AdakHaddad/mirror_NaSChipHack/pitch/README.md

# Pitch

Slide, naskah, dan video demo cadangan untuk Demo Day 23 Oktober 2026.

| File | Isi |
|---|---|
| [pitch_deck.md](pitch_deck.md) | Naskah 5 menit per slide |
| [question.md](question.md) | Persiapan tanya jawab 3 menit (jawaban bahasa Inggris) |
| [catatan-pembanding.md](catatan-pembanding.md) | Pembanding produk (BQ40Z50, DS28E38, ADI wBMS) |
