AdakHaddad/mirror_NaSChipHack/bisnis/README.md

# Business Model

Business model, analisis pasar, dan proyeksi dampak SeBatt.

| File | Isi |
|---|---|
| [business_model.md](business_model.md) | Model bisnis dan analisis pasar (TAM/SAM/SOM, pendapatan, GTM); sebagian angka belum bersumber — angka pitch final di `pitch-dan-angka.md` |
| [lean-canvas.md](lean-canvas.md) | Lean Canvas; bagian **[Isi]** dijawab di `pitch-dan-angka.md` |
| [pitch-dan-angka.md](pitch-dan-angka.md) | Naskah pitch, framework, asumsi angka bersumber, dan posisi startup |

Naskah demo day ada di [../pitch/pitch_deck.md](../pitch/pitch_deck.md);
pembanding produk di [../pitch/catatan-pembanding.md](../pitch/catatan-pembanding.md).

Aturan: setiap angka di dokumen mana pun harus berlabel **[Sumber]** (dengan
tautan) atau **[Asumsi]** (dengan dasar). Angka tanpa label jangan dipakai di
pitch.
