AdakHaddad/mirror_NaSChipHack/docs/catatan-teknis/council-18-okt.md

# Catatan Teknis 18 Oktober 2026

Ringkasan diskusi Guntur tentang arah teknis dan demo menjelang onsite. Dibaca semua anggota sebelum rapat.

> **Revisi 19 Okt 2026:** keputusan ADC berubah — **ADS1115 (I2C)** menggantikan MCP3202 (SPI) karena modul SPI tidak tersedia. Board latihan tetap **Cmod S7**; KV260 hari-H. Angka dan keputusan lain di catatan ini tetap berlaku.

## Kenapa Arah Perlu Disesuaikan

Proposal yang lolos menjanjikan dua hal yang akan dicek juri:

1. Setiap sampel tegangan dari ADC diberi **nomor urut** dan **ditandatangani HMAC** di dalam chip, lalu disimpan sebagai **riwayat**. Stasiun menolak riwayat yang diubah atau dihapus.
2. Semua itu dikerjakan **rangkaian RTL tanpa prosesor lunak**.

Poin 1 adalah satu-satunya pembeda SeBatt dari chip komersial. TI BQ40Z50 sudah mengukur tegangan, menyimpan *lifetime log*, dan punya SHA-1 untuk mengautentikasi **paket** kepada host. Yang tidak dimilikinya adalah tanda tangan atas riwayat itu sendiri: log tersimpan polos di data flash, tanpa nomor urut, dan dapat ditulis ulang lewat akses data flash (bqStudio). Pembanding terkuatnya pun begitu: MAX17205 memakai SHA-256, tetapi tetap hanya anti-kloning paket, bukan integritas riwayat.

Kondisi repo saat ini:

- Core SHA-256 dan HMAC sudah lolos 9/9 vektor uji. Ini fondasi yang tetap dipakai.
- Desain FPGA memakai MicroBlaze dan firmware C di Nexys A7/Basys 3. Saat onsite kita wajib memakai **AMD Kria KV260** dari panitia, dan proposal menulis tanpa prosesor lunak.
- ADC, nomor urut, buffer riwayat, dan lock di chip belum ada. Tegangan masih angka tetap 3700 mV.

## Keputusan yang Diusulkan

- Jalur MicroBlaze **dibekukan** dan disimpan sebagai cadangan, tidak dihapus.
- Tenaga RTL dialihkan ke rangkaian ini, semuanya di logika FPGA:

```
ADC (ADS1115) → i2c_master + ads1115_ctrl → auth_ctrl (nomor urut, buffer riwayat, lock) → hmac_sha256 → uart_if → laptop stasiun
```

- Gambaran alurnya ada di [gambar alur teknis](../gambar/alur-teknis.png). Format pesan UART, perintah riwayat, dan kode status disepakati di rapat sebagai kontrak antara Muqtada (RTL) dan Budi (Python).

## Catatan KV260

- **Clock** logika FPGA berasal dari prosesor ARM di board, jadi blok Zynq UltraScale+ MPSoC tetap dipasang di block design sebagai sumber clock.
- **Cara menjalankan.** Boot image Ubuntu KV260 dari SD card, lalu muat bitstream dengan `xmutil` atau `fpgautil`. Bagian ini cocok dipegang Muqtada karena terbiasa dengan Linux.
- **UART** bawaan board terhubung ke prosesor, bukan ke logika FPGA. UART dari rangkaian kita keluar lewat **PMOD** dan adaptor USB-UART (misalnya CP2102).
- **Hanya ada satu PMOD** (8 pin). Pin itu cukup untuk ADS1115 I2C (2 pin), UART (2 pin), dan LED (1 pin).
- Board baru kita pegang 21 Oktober, jadi seluruh rangkaian **diuji dulu di Cmod S7**.
- Cek apakah instalasi Vivado sudah mendukung device **xck26**.

## Rancangan Demo

Cerita: baterai dipakai sekitar seminggu, sekali dikuras sampai habis, lalu catatan kejadian itu dihapus.

1. **Pemakaian normal.** Hasilnya diterima.
2. **Juri memutar kenop** sampai baterai terkuras, lalu catatannya dihapus. Layar menampilkan "Catatan jam 14–17 hilang, DITOLAK".
3. **Angka diubah** dari 2,0 V menjadi 3,6 V. Hasilnya "DITOLAK".

Ketentuan pendukung:

- Tulisan di layar memakai bahasa awam, tanpa kode status. Hurufnya besar.
- Satu slide pembanding: "BMS biasa: DITERIMA", "SeBatt: DITOLAK".
- Peran BMS curang dijalankan di **laptop kedua**, di antara board dan laptop stasiun.
- Board diberi label "CHIP SeBatt", dan LED besar di breadboard menyala hijau atau merah.
- Buffer berisi 64 sampel. Satu titik mewakili 3 jam, jadi totalnya sekitar 8 hari.
- Apabila board tidak merespons dalam 10 detik, video cadangan diputar.
- Replay dan lock tidak ditampilkan di demo. Keduanya disiapkan untuk tanya jawab.

## Pembagian Tugas

| Orang | Tugas |
|---|---|
| Muqtada | auth_ctrl (nomor urut, buffer, lock). Boot KV260 dan memuat bitstream |
| Guntur | i2c_master + ads1115_ctrl, uart_if, membeli dan merangkai ADS1115, uji di Cmod S7, constraint PMOD KV260, pitch deck |
| Budi | Dashboard stasiun, program BMS curang, testbench cocotb, dataset cadangan dari data baterai, angka bisnis bersumber |

## Jadwal

| Waktu | Target |
|---|---|
| Senin 19 Okt | Sepakat soal MicroBlaze dan protokol. Beli ADS1115, adaptor USB-UART, potensiometer |
| Selasa 20 Okt | Rangkaian lengkap jalan di Cmod S7. Video cadangan direkam |
| Rabu 21 Okt | Boot dan port ke KV260 |
| Kamis 22 Okt, 22.00 | Kirim slide, repositori, dan README 2 halaman |
| Jumat 23 Okt, 08.00 | Batas pengumpulan panitia |

README 2 halaman wajib memuat diagram blok, cara menjalankan, hasil uji, dan poin penggunaan AI.

## Jawaban untuk Pertanyaan Juri

| Pertanyaan | Jawaban |
|---|---|
| Kalau daya dicabut? | Nomor urut kembali ke nol, dan stasiun mendeteksinya sebagai rollback. Produk akhir butuh penghitung permanen (NVM) |
| Apakah kunci bisa dibaca? | Di produk tidak. key_vault dibuat sekali tulis tanpa port baca, dan setiap chip punya kunci berbeda |
| Apakah data ADC bisa dipalsukan? | Bisa, sebelum masuk chip. Pada chip akhir, ADC berada di dalam chip yang sama |
| Kalau basis data bocor? | Kunci ikut bocor. Ini batasan skema kunci simetris |
| Apa bedanya dengan BQ40Z50? | BQ40Z50 menyimpan lifetime log dan punya SHA-1, tetapi keduanya untuk keaslian paket: host mengautentikasi identitas, bukan isi riwayat. Log-nya tidak ditandatangani, tanpa nomor urut, dan dapat ditulis ulang lewat akses data flash. SeBatt menandatangani setiap sampel di titik ukur, sehingga riwayat yang diubah, dihapus, atau diputar balik tertolak |

## Pembanding Produk dan Riset

Ancaman yang dijawab SeBatt berbeda dari pembanding yang ada. Produk dan riset di bawah ini melindungi pemilik merek dari pemalsu atau penyerang jaringan, sedangkan SeBatt melindungi stasiun dan pembeli dari pemilik baterai yang memanipulasi riwayat baterainya sendiri.

| | TI BQ40Z50 | ADI MAX17205 | SeBatt |
|---|---|---|---|
| Riwayat | Lifetime log + black box recorder, diperbarui tiap 2 jam | History log | Tiap sampel tegangan bernomor urut |
| Tanda tangan riwayat | Tidak ada | Tidak ada | HMAC-SHA-256 per sampel, di dalam IP |
| Anti-rollback | Tidak ada | Tidak ada | Nomor urut + anchor last_seq di stasiun |
| Autentikasi yang ada | SHA-1, host mengautentikasi paket (anti-kloning) | SHA-256, 160-bit, anti-kloning | Identitas dari PUF, riwayat dari tanda tangan |
| Kunci | Secure memory di gauge | 160-bit secret key | Dari PUF, tidak disimpan permanen (tahap 2) |

Rujukan pembanding:

- TI, *BQ40Z50 datasheet* — lifetime log, black box recorder, SHA-1: <https://www.ti.com/lit/ds/symlink/bq40z50.pdf>
- ADI, *MAX17205* — SHA-256 untuk anti-kloning paket: <https://www.analog.com/en/products/max17205.html>
- Basic dkk. (Graz), "Secure Data Acquisition for Battery Management Systems", DSD 2023 — struktur log BMS dan pengamanan transfer ke cloud: <https://doi.org/10.1109/DSD60849.2023.00082>
- Marchiori & Conti, "Your Battery Is a Blast!", CCS 2023 — autentikasi baterai dari ciri sel: <https://doi.org/10.1145/3576915.3623179>
- Blümke dkk., "Security Concerns in Transitioning BMS from First to Second Life", ARES 2024 — verifikasi integritas data sebagai kebutuhan saat transisi: <https://doi.org/10.1145/3664476.3671010>

## Kerapian Repositori

- File hasil generate Vivado (.dcp, .xci, cache) dikeluarkan dari repo. Proyek dibangun ulang dari skrip TCL.
- Tambahkan .gitattributes agar perbedaan line ending Windows dan Linux tidak membuat diff palsu.
- Atur email git sesuai akun GitHub masing-masing:

```
git config --global user.email "email@contoh.com"
```
