AdakHaddad/mirror_NaSChipHack/pitch/pitch_deck.pdf

[Team ID] – [Team name]

# How to use this template

### Delete this slide before presenting

- The theme (design) of this template must be used for your pitch slides.
- All slides must be written in English. Presenting in English is strongly encouraged.
- The content, titles, order, and number of slides here are examples only. Change them freely, as long as they fit your presentation time.
- Grey text in [square brackets] is guidance only. Replace it with your own content.
- Your team decides how to split the slot between presentation and demo.
- Save as PDF or PPTX and submit before Day 3 at 08:00 WIB.

## T01 – NaS

# SeBatt

## Secure Battery Identity & Tamper-Evident History

## Internet of Things · Universitas Gadjah Mada

### Guntur Sulistyo · Muhammad Budi Setiawan · Muhammad Muqtada Alhaddad

Hackathon Deeptech 2026 · Demo Day, 23 October 2026

Condition | Problem | Solution
Battery are shared, so the station 139,45 M | must trust a battery.

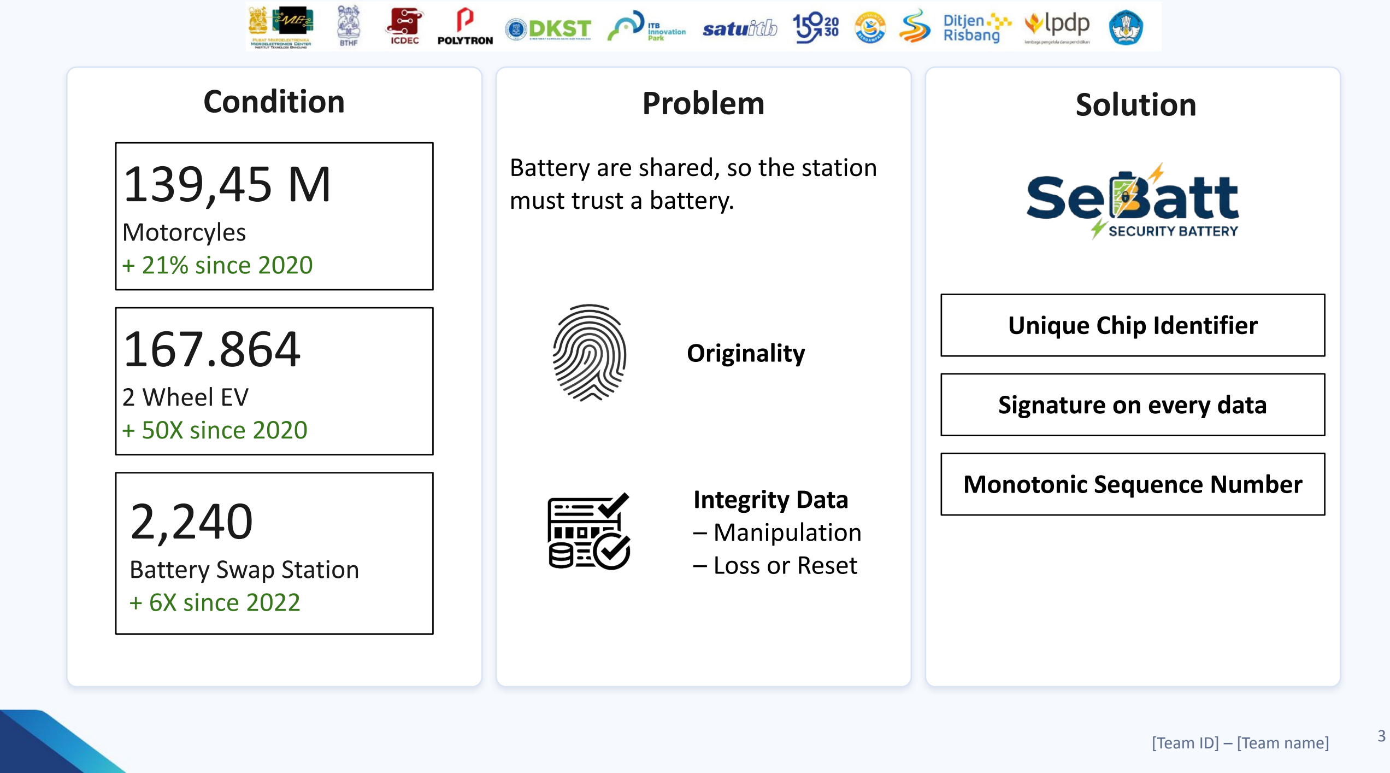
[picture p6: page 3]

[Team ID] – [Team name] 3

## Motorcyles + 21% since 2020

167.864

## 2 Wheel EV + 50X since 2020

2,240

## Battery Swap Station + 6X since 2022

## Originality

## Integrity Data – Manipulation – Loss or Reset

## Unique Chip Identifier

## Signature on every data

## Monotonic Sequence Number

Key Activities | Key Resource | Key Partnership
| IP Design & HKI

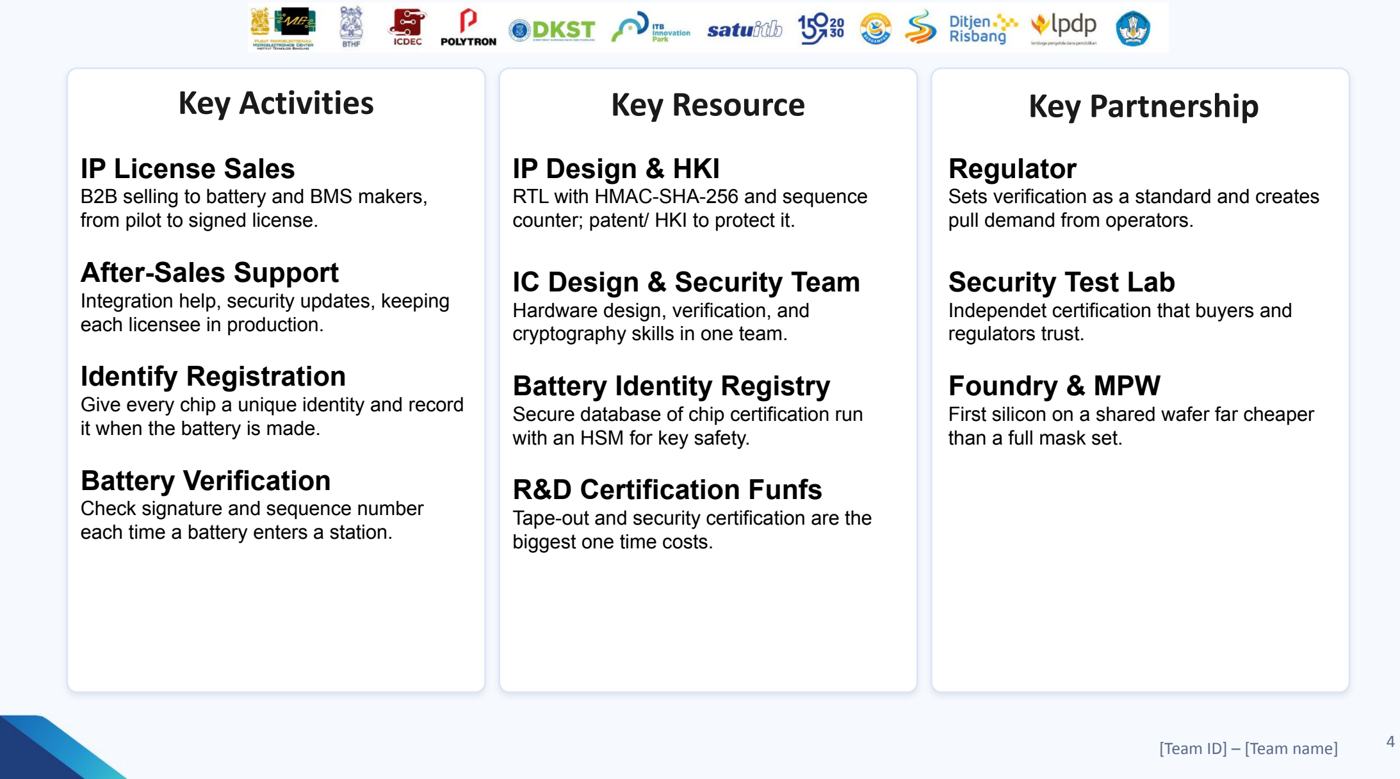
[picture p7: page 4]

[Team ID] – [Team name] 4

## IP License Sales

B2B selling to battery and BMS makers, from pilot to signed license.

## After-Sales Support

Integration help, security updates, keeping each licensee in production.

## Identify Registration

Give every chip a unique identity and record it when the battery is made.

## Battery Verification

Check signature and sequence number each time a battery enters a station.

RTL with HMAC-SHA-256 and sequence counter; patent/ HKI to protect it.

## IC Design & Security Team

Hardware design, verification, and cryptography skills in one team.

## Battery Identity Registry

Secure database of chip certification run with an HSM for key safety.

## R&D Certification Funfs

Tape-out and security certification are the biggest one time costs.

## Regulator

Sets verification as a standard and creates pull demand from operators.

## Security Test Lab

Independet certification that buyers and regulators trust.

## Foundry & MPW

First silicon on a shared wafer far cheaper than a full mask set.

Customer Segment | Channels | Customer Relationship
| Awareness

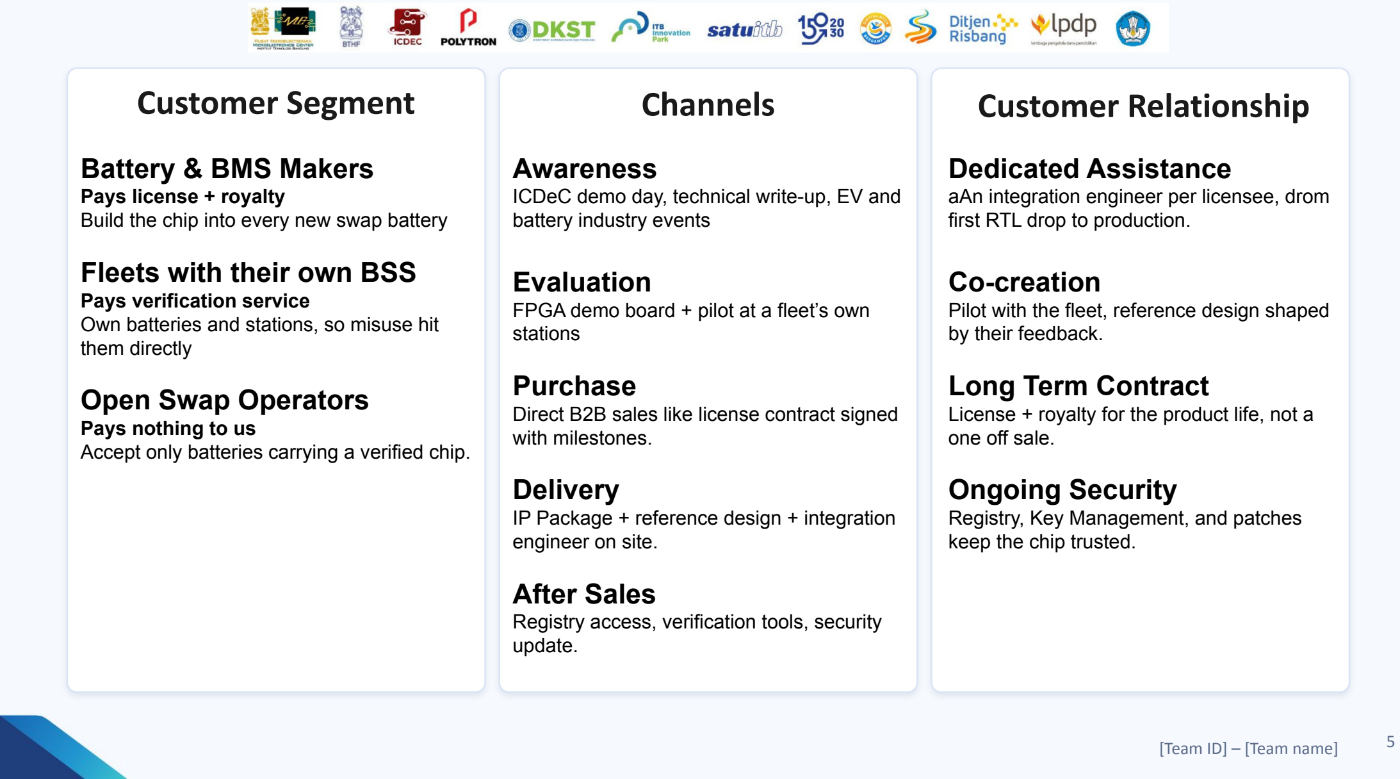
[picture p8: page 5]

[Team ID] – [Team name] 5

## Battery & BMS Makers

Pays license + royalty
Build the chip into every new swap battery

## Fleets with their own BSS

Pays verification service
Own batteries and stations, so misuse hit them directly

## Open Swap Operators

Pays nothing to us
Accept only batteries carrying a verified chip.

ICDeC demo day, technical write-up, EV and battery industry events

## Evaluation

FPGA demo board + pilot at a fleet’s own stations

## Purchase

Direct B2B sales like license contract signed with milestones.

## Delivery

IP Package + reference design + integration engineer on site.

## After Sales

Registry access, verification tools, security update.

## Dedicated Assistance

aAn integration engineer per licensee, drom first RTL drop to production.

## Co-creation

Pilot with the fleet, reference design shaped by their feedback.

## Long Term Contract

License + royalty for the product life, not a one off sale.

## Ongoing Security

Registry, Key Management, and patches keep the chip trusted.

# Cost Structure

## One Time

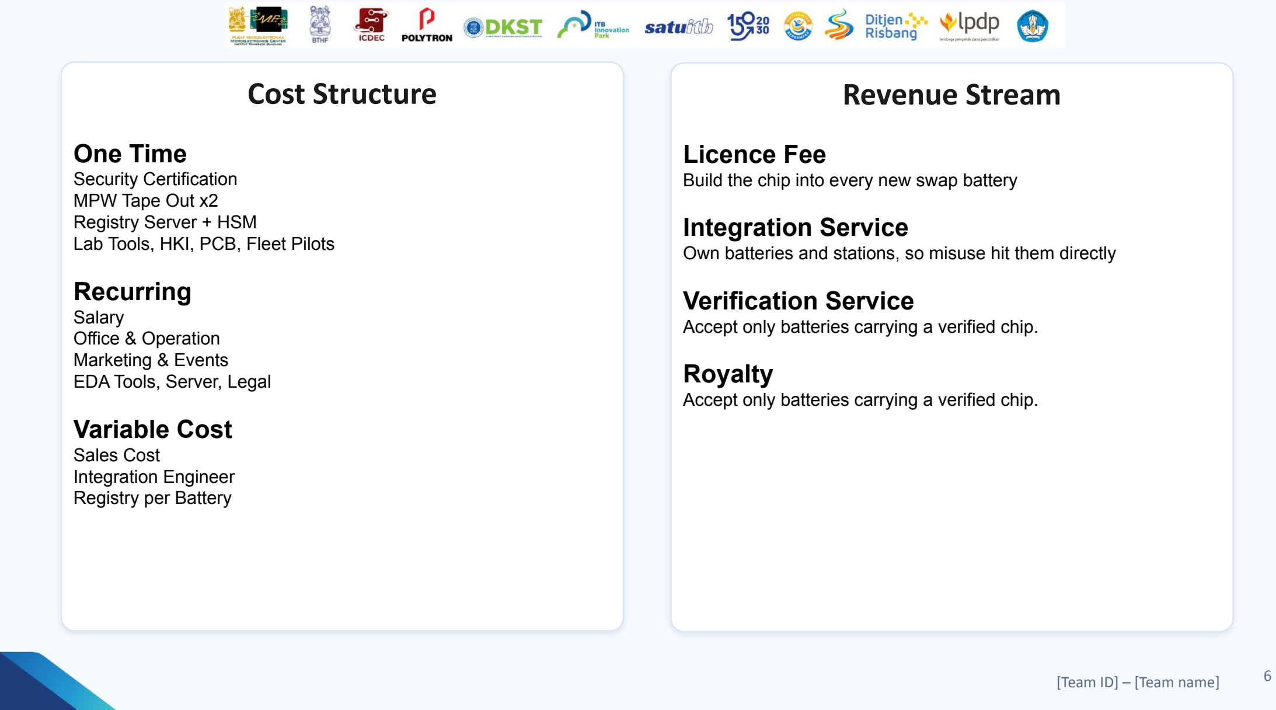
[picture p9: page 6]

[Team ID] – [Team name] 6

Security Certification
MPW Tape Out x2
Registry Server + HSM
Lab Tools, HKI, PCB, Fleet Pilots

## Recurring

Salary
Office & Operation
Marketing & Events
EDA Tools, Server, Legal

## Variable Cost

Sales Cost
Integration Engineer
Registry per Battery

# Revenue Stream

## Licence Fee

Build the chip into every new swap battery

## Integration Service

Own batteries and stations, so misuse hit them directly

## Verification Service

Accept only batteries carrying a verified chip.

## Royalty

Accept only batteries carrying a verified chip.

# Trend of EV Motorcycle

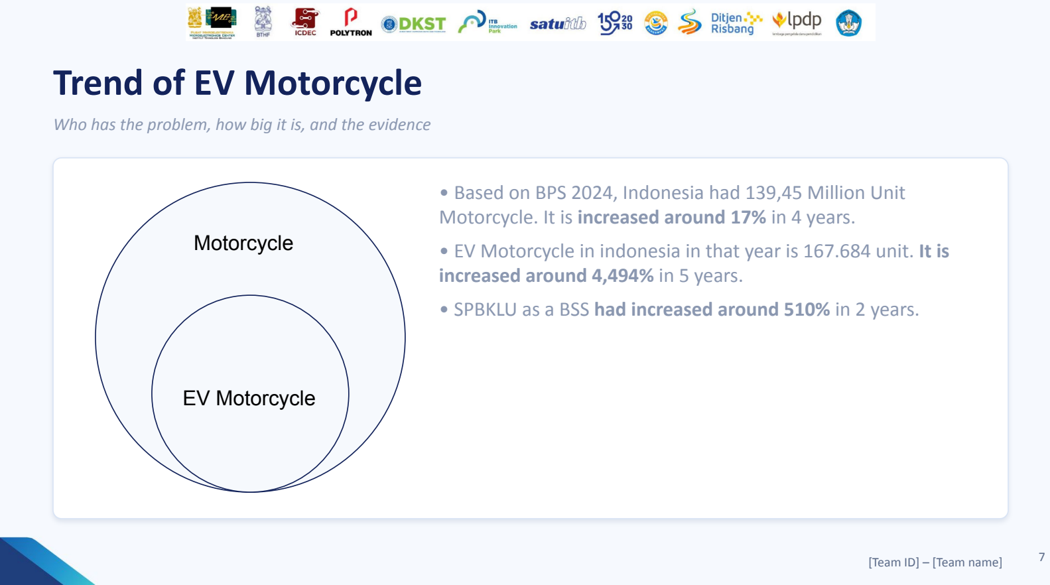
[picture p10: page 7]

### Who has the problem, how big it is, and the evidence

## - Based on BPS 2024, Indonesia had 139,45 Million Unit

Motorcycle. It is increased around 17% in 4 years.

## - EV Motorcycle in indonesia in that year is 167.684 unit. It is

increased around 4,494% in 5 years.

- SPBKLU as a BSS had increased around 510% in 2 years.

## Motorcycle

## EV Motorcycle

# Battery Swap EV Motorcycle

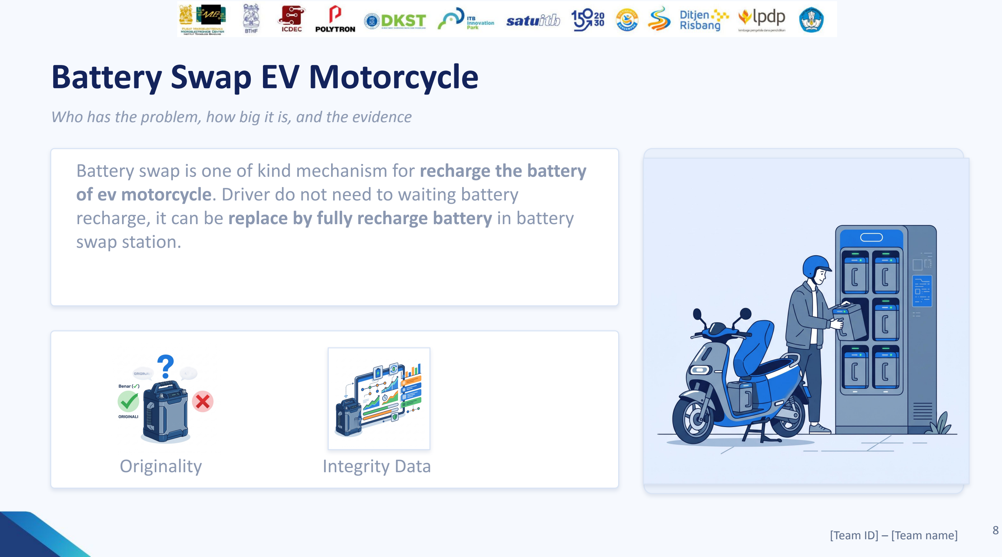
[picture p11: page 8]

### Who has the problem, how big it is, and the evidence

## Battery swap is one of kind mechanism for recharge the battery of ev motorcycle. Driver do not need to waiting battery recharge, it can be replace by fully recharge battery in battery

swap station. | [Key figure]

### [Short explanation of the figure and its data source]

Originality | Integrity Data

# How SeBatt can Solve the Problem

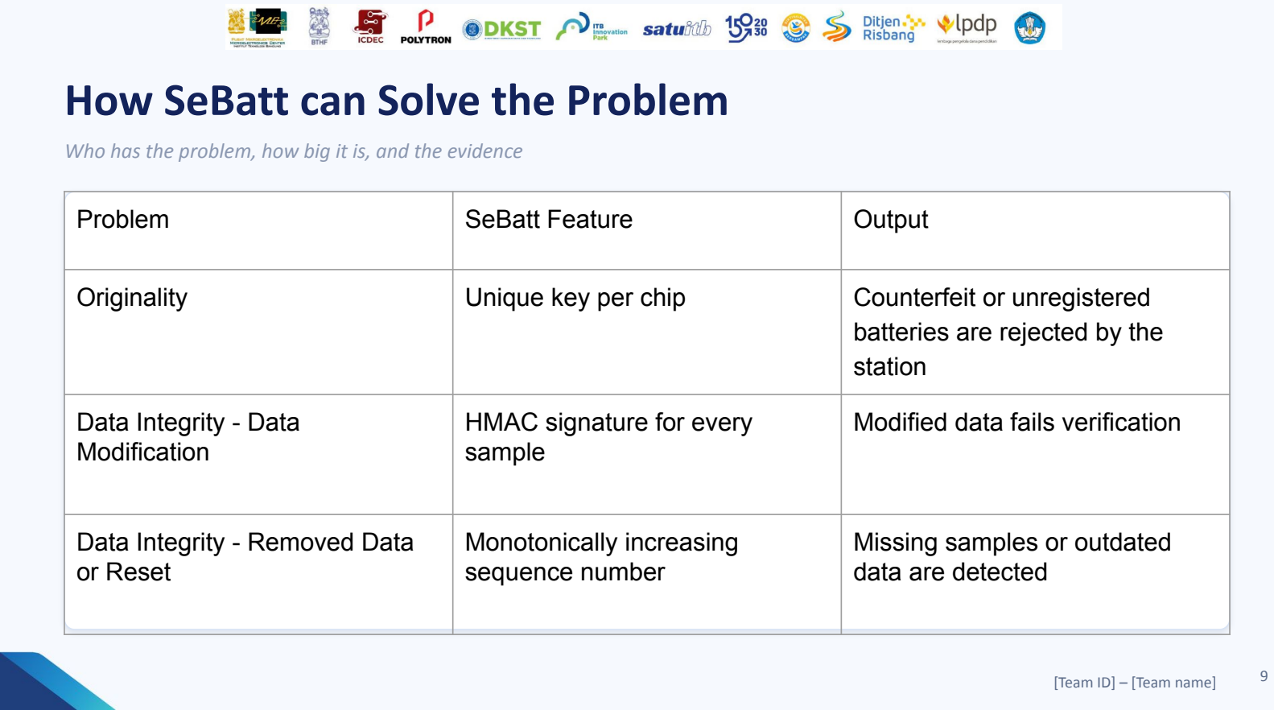
[picture p12: page 9]

### Who has the problem, how big it is, and the evidence

Problem | SeBatt Feature | Output
Originality | Unique key per chip | Counterfeit or unregistered batteries are rejected by the station
Data Integrity - Data Modification | HMAC signature for every sample | Modified data fails verification
Data Integrity - Removed Data or Reset | Monotonically increasing sequence number | Missing samples or outdated data are detected

# Positioning SeBatt

Kemampuan | DS28E38 | BQ40Z50 | ADI wBMS | SeBatt

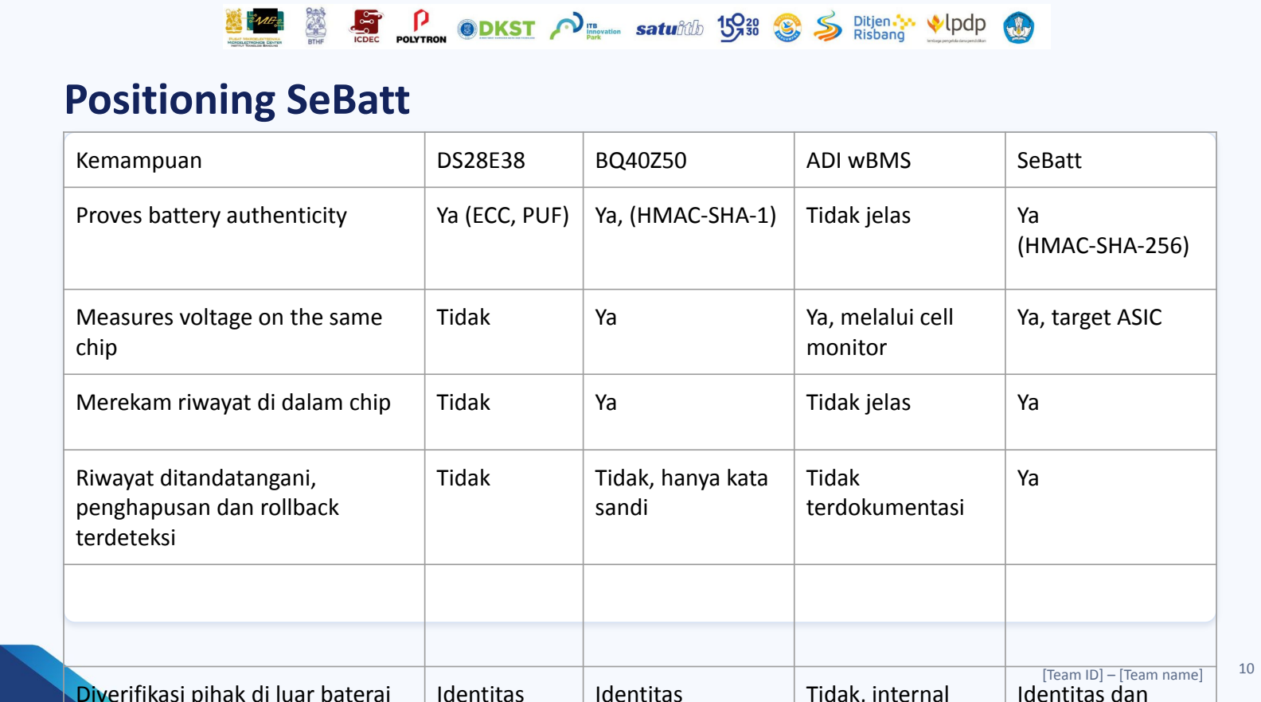
[picture p13: page 10]

Proves battery authenticity | Ya (ECC, PUF) | Ya, (HMAC-SHA-1) | Tidak jelas | Ya (HMAC-SHA-256)
Measures voltage on the same chip | Tidak | Ya | Ya, melalui cell monitor | Ya, target ASIC
Merekam riwayat di dalam chip | Tidak | Ya | Tidak jelas | Ya
Riwayat ditandatangani, penghapusan dan rollback terdeteksi | Tidak | Tidak, hanya kata sandi | Tidak terdokumentasi | Ya
Diverifikasi pihak di luar baterai | Identitas | Identitas | Tidak, internal

## Identitas dan

# Competitor Analysis

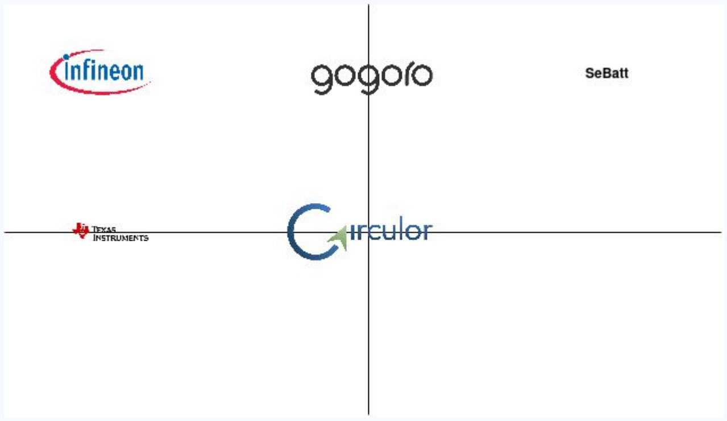
[picture p14: figure]

# Solution and system architecture

### How it works from input to output

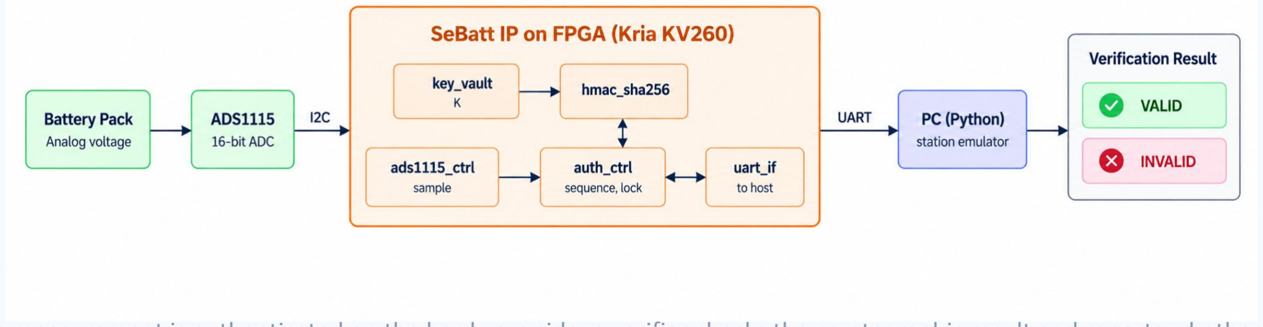
[picture p15: figure]

The measurement is authenticated on the hardware side; a verifier checks the cryptographic result and reports whether the tested record matches. The current PoC validates fixed-input RTL and offline verification; live ADC-to-history integration is still planned.

# Role of the chip

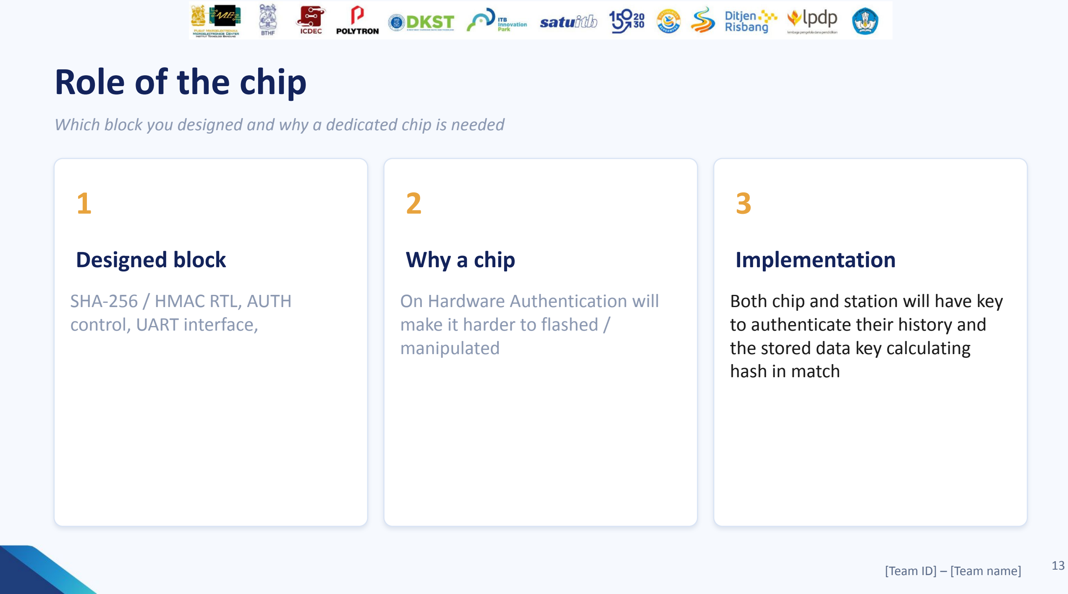
[picture p16: page 13]

### Which block you designed and why a dedicated chip is needed

1

## Designed block

## SHA-256 / HMAC RTL, AUTH

control, UART interface,

2

## Why a chip

## On Hardware Authentication will make it harder to flashed / manipulated

3

## Implementation

## Both chip and station will have key to authenticate their history and the stored data key calculating hash in match

# PoC demo and evaluation results

### What works and how well it performs

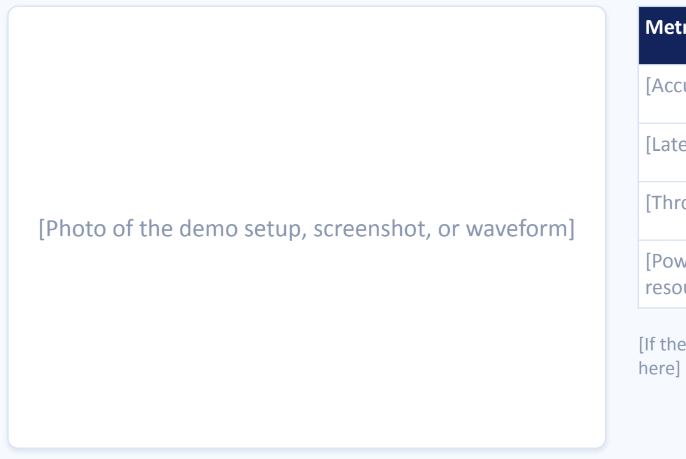
[picture p17: figure]
here]

## [Photo of the demo setup, screenshot, or waveform]

Metric | Result | Target / baseline
[Accuracy] | [...] | [...]
[Latency] | [...] | [...]
[Throughput] | [...] | [...]
[Power / FPGA resources] | [...] | [...]

[If the input comes from data rather than a live sensor, state it

# Design Timing Summary

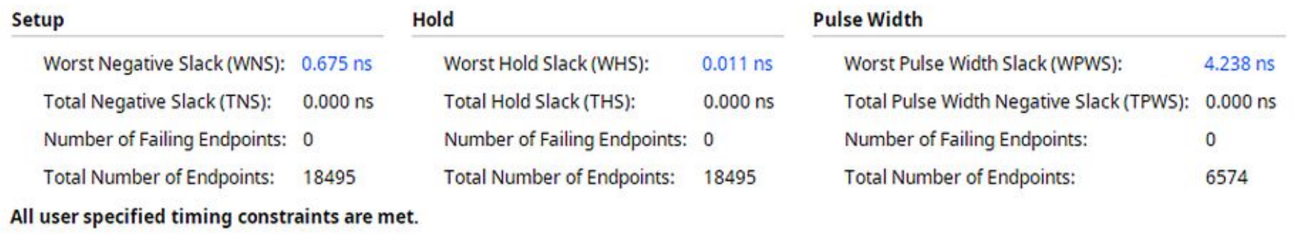
[picture p18: figure]

# Utilization

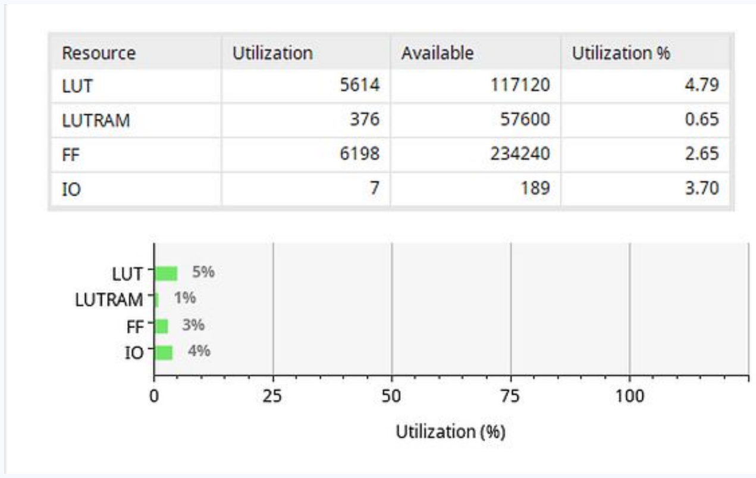
[picture p19: figure]

# Power analysis

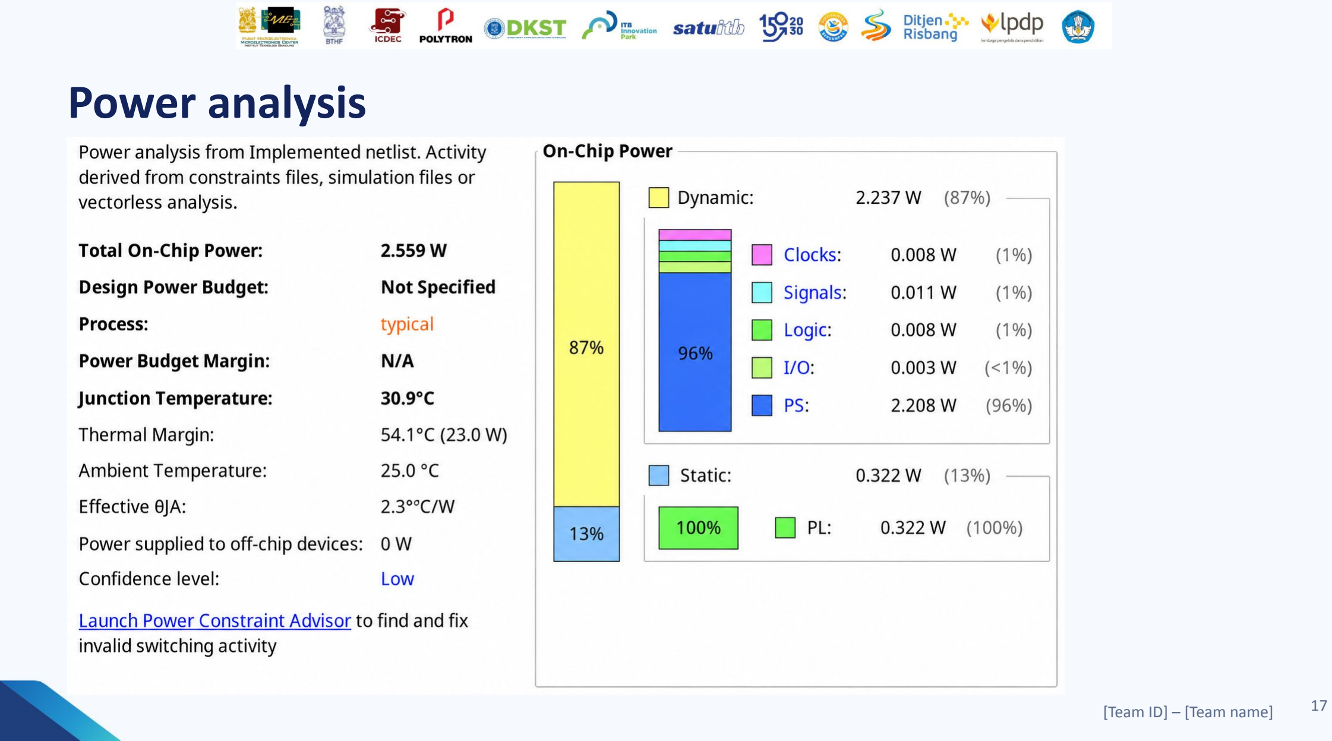
[picture p20: page 17]

### What works and how well it performs

# Business model

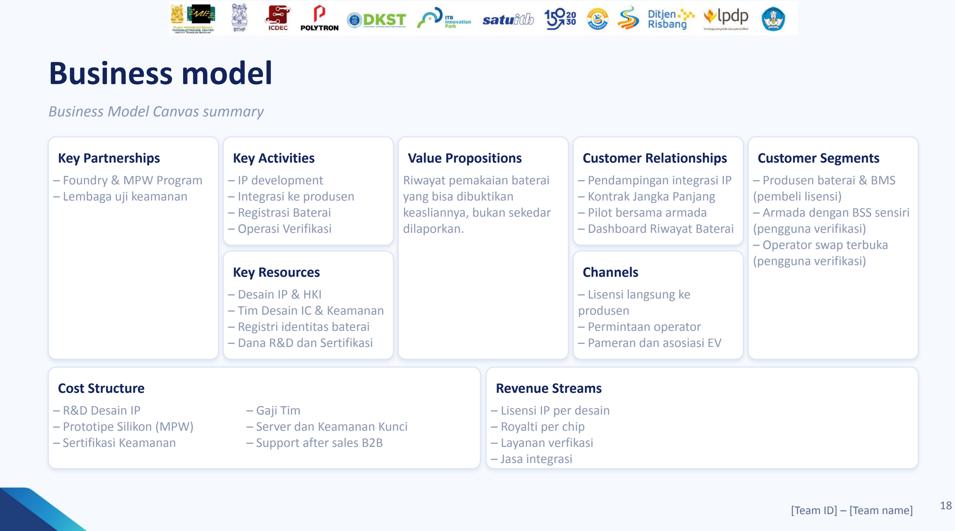
[picture p21: page 18]

### Business Model Canvas summary

Key Partnerships

– Foundry & MPW Program
– Lembaga uji keamanan

Key Activities

– IP development
– Integrasi ke produsen
– Registrasi Baterai
– Operasi Verifikasi

Key Resources

– Desain IP & HKI
– Tim Desain IC & Keamanan – Registri identitas baterai – Dana R&D dan Sertifikasi

Value Propositions

Riwayat pemakaian baterai
yang bisa dibuktikan
keasliannya, bukan sekedar dilaporkan.

Customer Relationships

– Pendampingan integrasi IP – Kontrak Jangka Panjang
– Pilot bersama armada
– Dashboard Riwayat Baterai

Channels

– Lisensi langsung ke
produsen
– Permintaan operator
– Pameran dan asosiasi EV

Customer Segments

– Produsen baterai & BMS
(pembeli lisensi)
– Armada dengan BSS sensiri (pengguna verifikasi)
– Operator swap terbuka
(pengguna verifikasi)

Cost Structure

– R&D Desain IP | – Gaji Tim
– Prototipe Silikon (MPW) | – Server dan Keamanan Kunci
– Sertifikasi Keamanan | – Support after sales B2B

Revenue Streams

– Lisensi IP per desain
– Royalti per chip
– Layanan verfikasi
– Jasa integrasi

# Our business model

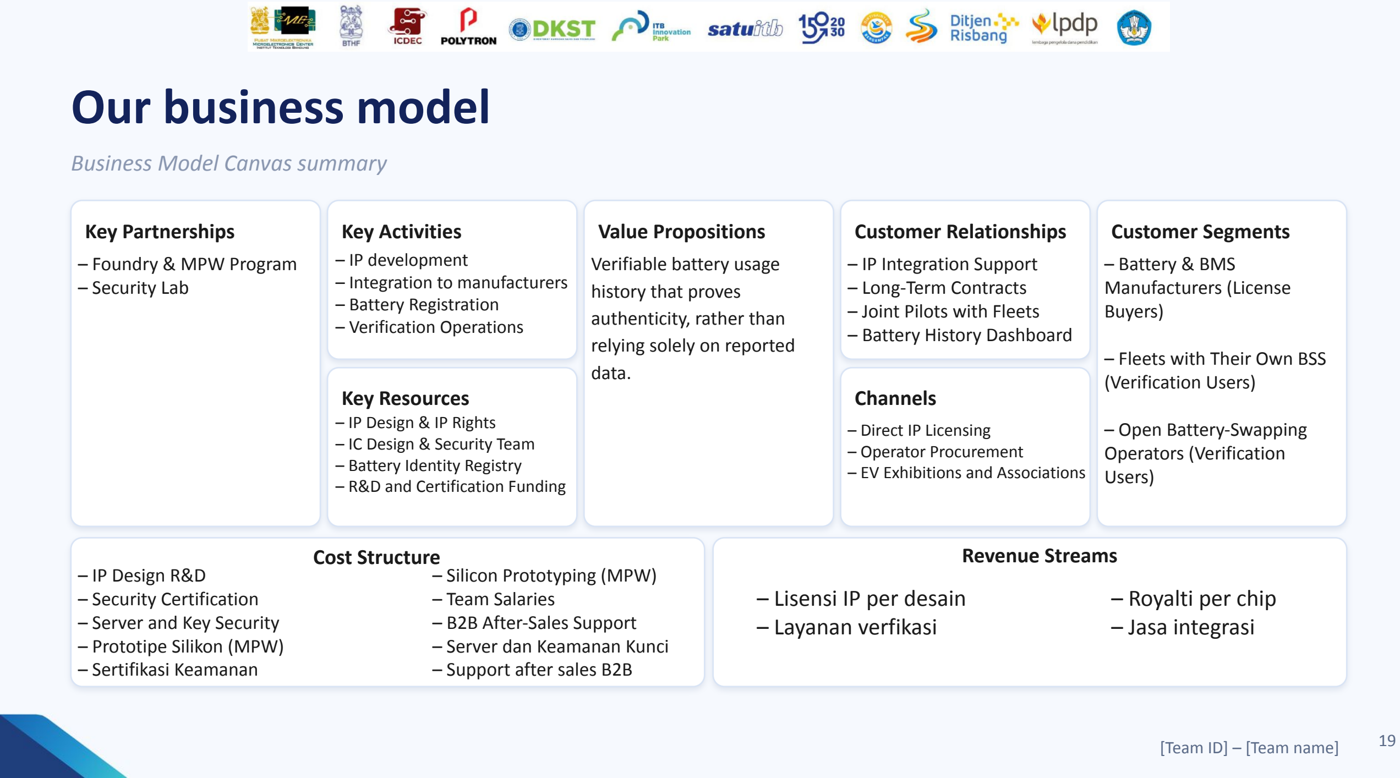
[picture p22: page 19]

### Business Model Canvas summary

Key Partnerships

– Foundry & MPW Program
– Security Lab

Key Activities
– IP development
– Integration to manufacturers – Battery Registration
– Verification Operations

Key Resources
– IP Design & IP Rights
– IC Design & Security Team
– Battery Identity Registry
– R&D and Certification Funding

Value Propositions

Verifiable battery usage
history that proves
authenticity, rather than
relying solely on reported data.

Customer Relationships

– IP Integration Support
– Long-Term Contracts
– Joint Pilots with Fleets
– Battery History Dashboard

Channels

– Direct IP Licensing
– Operator Procurement
– EV Exhibitions and Associations

Customer Segments

– Battery & BMS
Manufacturers (License
Buyers)

– Fleets with Their Own BSS (Verification Users)

– Open Battery-Swapping
Operators (Verification
Users)

Cost Structure
– IP Design R&D | – Silicon Prototyping (MPW)
– Security Certification | – Team Salaries
– Server and Key Security | – B2B After-Sales Support
– Prototipe Silikon (MPW) | – Server dan Keamanan Kunci
– Sertifikasi Keamanan | – Support after sales B2B

Revenue Streams

– Lisensi IP per desain | – Royalti per chip
– Layanan verfikasi | – Jasa integrasi

# Development roadmap

1

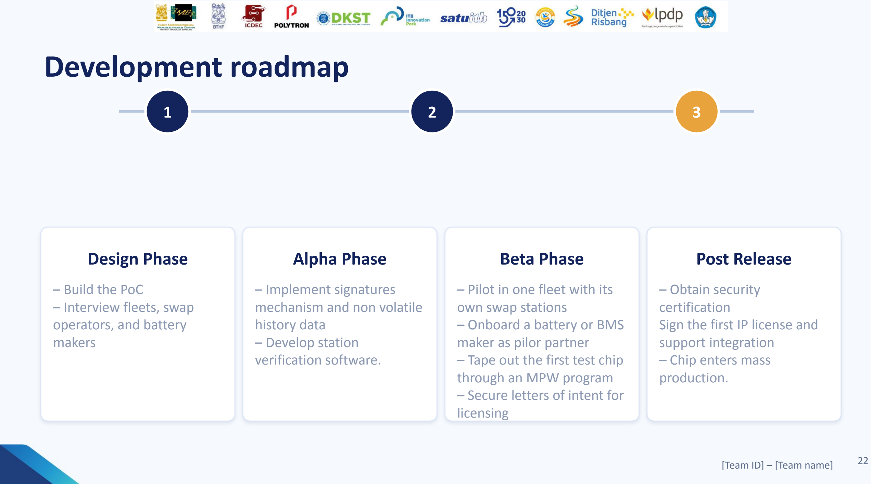
[picture p23: page 22]

## Design Phase

### – Build the PoC – Interview fleets, swap operators, and battery makers

2 3

## Alpha Phase

### – Implement signatures mechanism and non volatile history data – Develop station

verification software.

## Beta Phase

### – Pilot in one fleet with its own swap stations – Onboard a battery or BMS maker as pilor partner – Tape out the first test chip through an MPW program – Secure letters of intent for licensing

## Post Release

### – Obtain security certification Sign the first IP license and support integration – Chip enters mass

production.

# Thank you

## T01 – NaS

## [Team contact or repository link]

# Business model

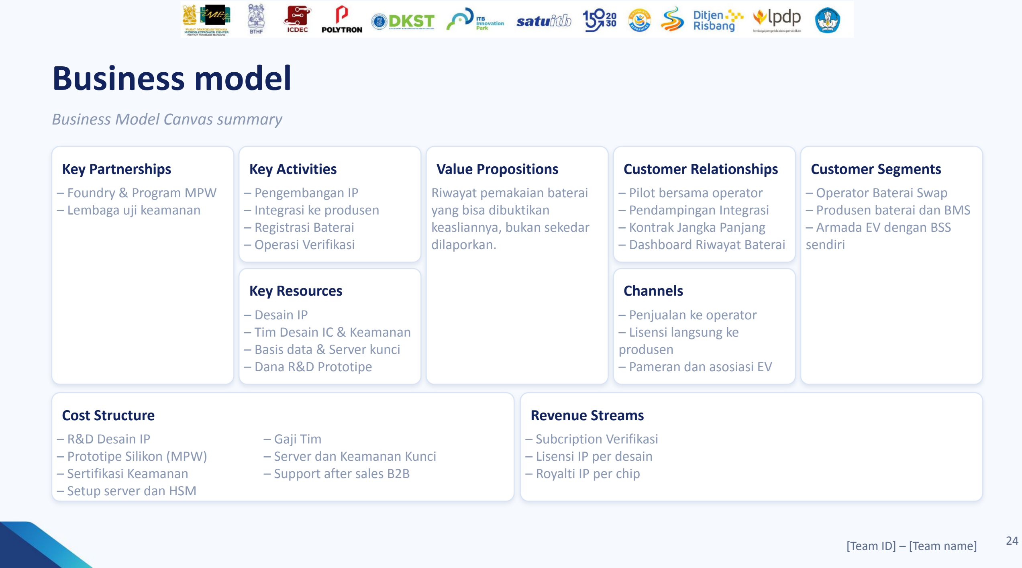
[picture p24: page 24]

### Business Model Canvas summary

Key Partnerships

– Foundry & Program MPW
– Lembaga uji keamanan

Key Activities

– Pengembangan IP
– Integrasi ke produsen
– Registrasi Baterai
– Operasi Verifikasi

Key Resources

– Desain IP
– Tim Desain IC & Keamanan – Basis data & Server kunci – Dana R&D Prototipe

Value Propositions

Riwayat pemakaian baterai
yang bisa dibuktikan
keasliannya, bukan sekedar dilaporkan.

Customer Relationships

– Pilot bersama operator
– Pendampingan Integrasi
– Kontrak Jangka Panjang
– Dashboard Riwayat Baterai

Channels

– Penjualan ke operator
– Lisensi langsung ke
produsen
– Pameran dan asosiasi EV

Customer Segments

– Operator Baterai Swap
– Produsen baterai dan BMS – Armada EV dengan BSS
sendiri

Cost Structure

– R&D Desain IP | – Gaji Tim
– Prototipe Silikon (MPW) | – Server dan Keamanan Kunci
– Sertifikasi Keamanan | – Support after sales B2B
– Setup server dan HSM

Revenue Streams

– Subcription Verifikasi
– Lisensi IP per desain
– Royalti IP per chip

## T01 – NaS

# [Solution Title]

## [One sentence: what problem you solve and for whom]

## Internet of Things · Universitas Gadjah Mada

### [Member 1] · [Member 2] · [Member 3] · [Member 4] · [Member 5]

Hackathon Deeptech 2026 · Demo Day, 23 October 2026

# Problem and target users

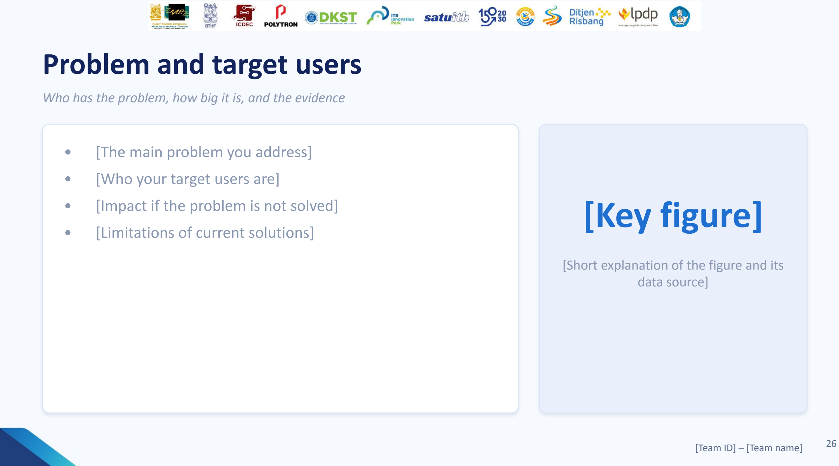
[picture p25: page 26]

### Who has the problem, how big it is, and the evidence

## - [The main problem you address]

## - [Who your target users are]

## - [Impact if the problem is not solved]

- | [Limitations of current solutions] | [Key figure]

### [Short explanation of the figure and its data source]

# Solution and system architecture

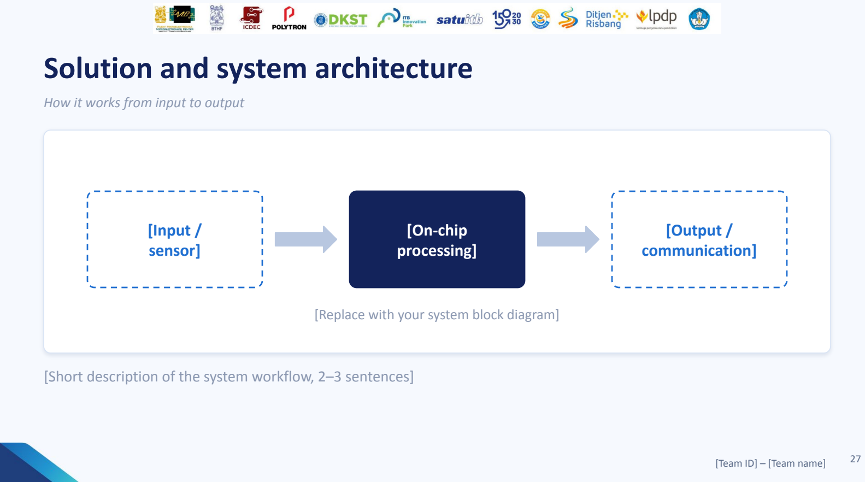
[picture p26: page 27]

### How it works from input to output

## [Input / sensor]

## [On-chip processing]

## [Output / communication]

### [Replace with your system block diagram]

## [Short description of the system workflow, 2–3 sentences]

# Role of the chip

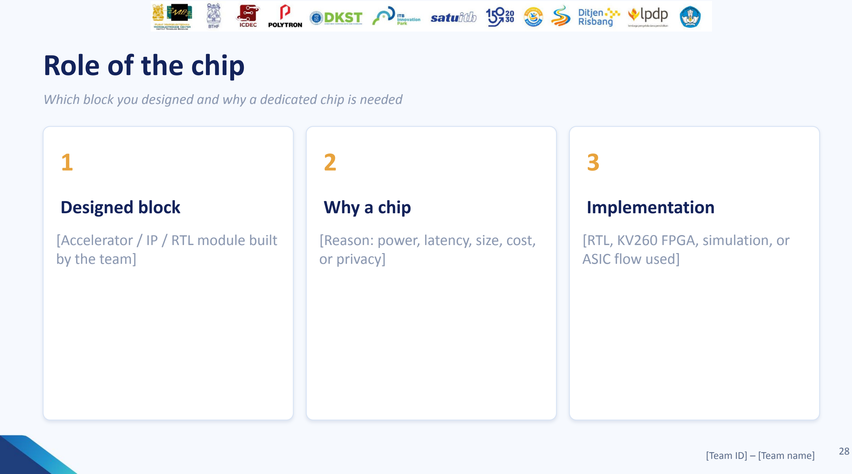
[picture p27: page 28]

### Which block you designed and why a dedicated chip is needed

1

## Designed block

## [Accelerator / IP / RTL module built by the team]

2

## Why a chip

[Reason: power, latency, size, cost,

## or privacy]

3

## Implementation

## [RTL, KV260 FPGA, simulation, or ASIC flow used]

# PoC demo and evaluation results

### What works and how well it performs

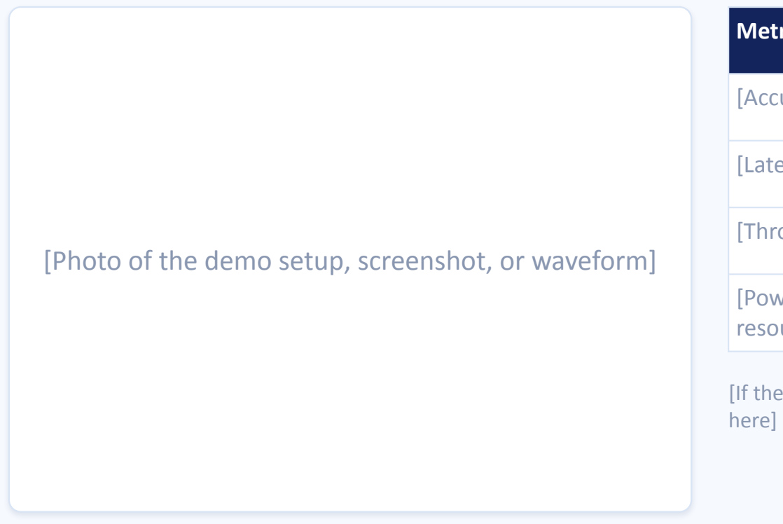
[picture p28: figure]
here]

## [Photo of the demo setup, screenshot, or waveform]

Metric | Result | Target / baseline
[Accuracy] | [...] | [...]
[Latency] | [...] | [...]
[Throughput] | [...] | [...]
[Power / FPGA resources] | [...] | [...]

[If the input comes from data rather than a live sensor, state it

# Business model

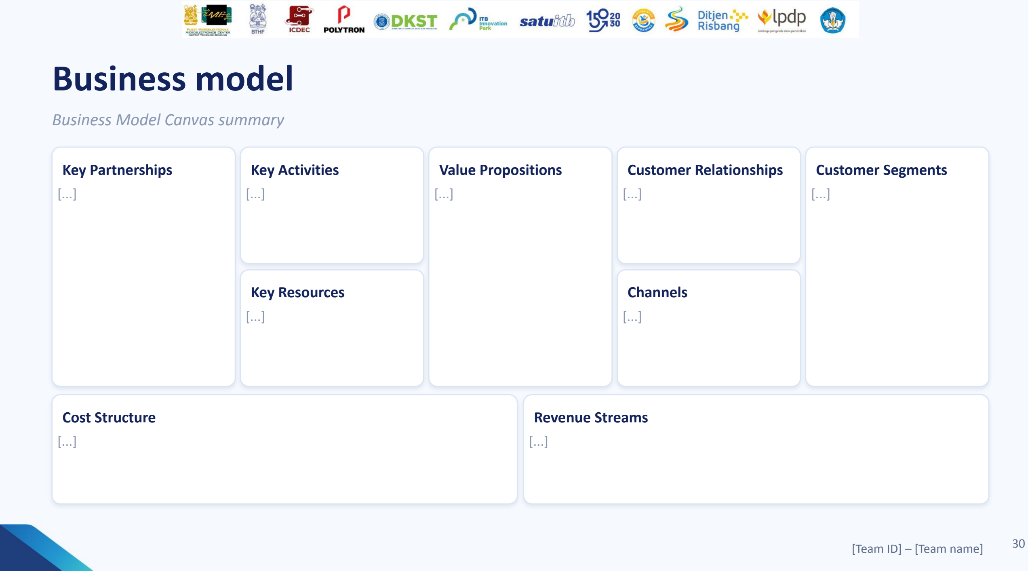
[picture p29: page 30]

### Business Model Canvas summary

Key Partnerships

[...]

Key Activities

[...]

Key Resources

[...]

Value Propositions

[...]

Customer Relationships

[...]

Channels

[...]

Customer Segments

[...]

Cost Structure

[...]

Revenue Streams

[...]

# Development roadmap

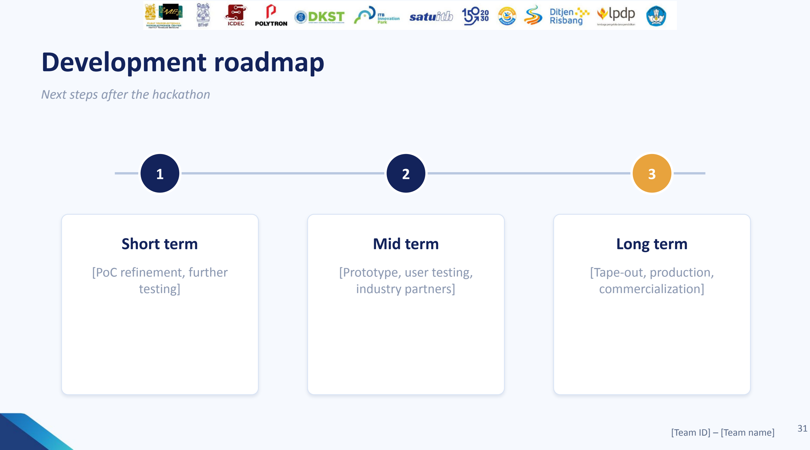
[picture p30: page 31]

### Next steps after the hackathon

1

## Short term

### [PoC refinement, further testing]

2

## Mid term

[Prototype, user testing,

### industry partners]

3

## Long term

[Tape-out, production,

### commercialization]

# Thank you

## [Team ID] – [Team name]

## [Team contact or repository link]
