AdakHaddad/mirror_NaSChipHack/docs/gambar/cloud-infra.pdf

# Infrastruktur Cloud & Basis Data Stasiun

Verifikasi HMAC dijalankan ulang di server operator; kunci tidak pernah disimpan di kios.

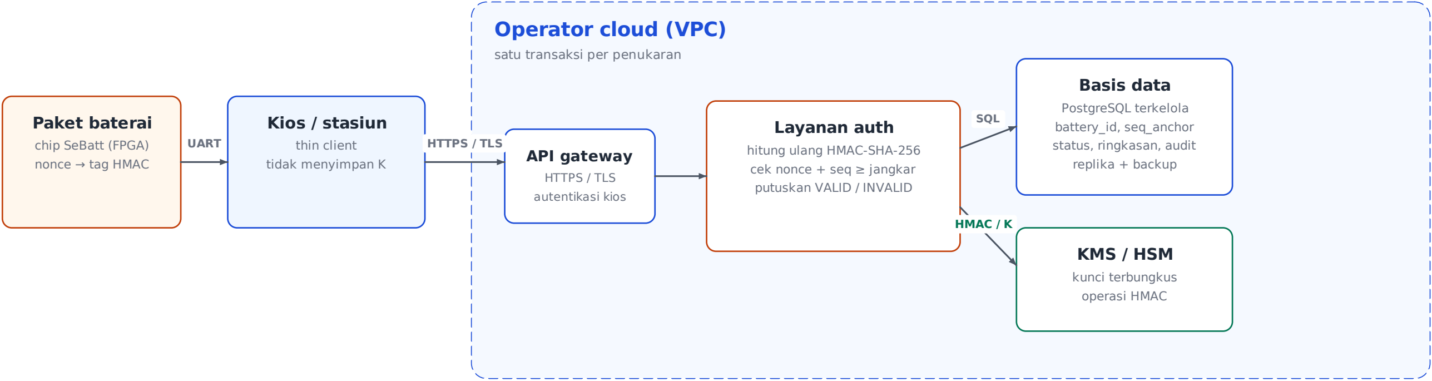
[picture p39: figure]
Paket baterai; chip SeBatt (FPGA) nonce → tag HMAC; Kios / stasiun; thin client tidak menyimpan K; Operator cloud (VPC); satu transaksi per penukaran; API gateway; HTTPS / TLS autentikasi kios; Layanan auth; hitung ulang HMAC-SHA-256 cek nonce + seq ≥ jangkar putuskan VALID / INVALID; Basis data; PostgreSQL terkelola battery_id, seq_anchor status, ringkasan, audit replika + backup; KMS / HSM; kunci terbungkus operasi HMAC; UART; HTTPS / TLS; SQL; HMAC / K

Tanda tangan tetap dibuat di silikon; cloud hanya menghitung ulang dan menyimpan jangkar.

BASIS DATA INTI

# 4 MB

100.000 baterai × 40 byte
ID, K, seq, status (tanpa tanda tangan)

RIWAYAT

# ±15 GB/tahun

riwayat lengkap 400 B/penukaran ringkasan peristiwa jauh lebih kecil

BIAYA INFRASTRUKTUR

# Rp 10–30 jt/tahun

cloud + KMS/HSM (asumsi)
100 ribuan baterai; lihat pitch-dan-angka.md

Tahap 1 (HMAC): kios wajib online setiap penukaran. Tahap 2 (ECDSA): verifikasi cukup public key, kios boleh offline; cloud menyimpan status dan revokasi.
