AdakHaddad/mirror_NaSChipHack/docs/gambar/alur-teknis.pdf

## A. Rantai perangkat

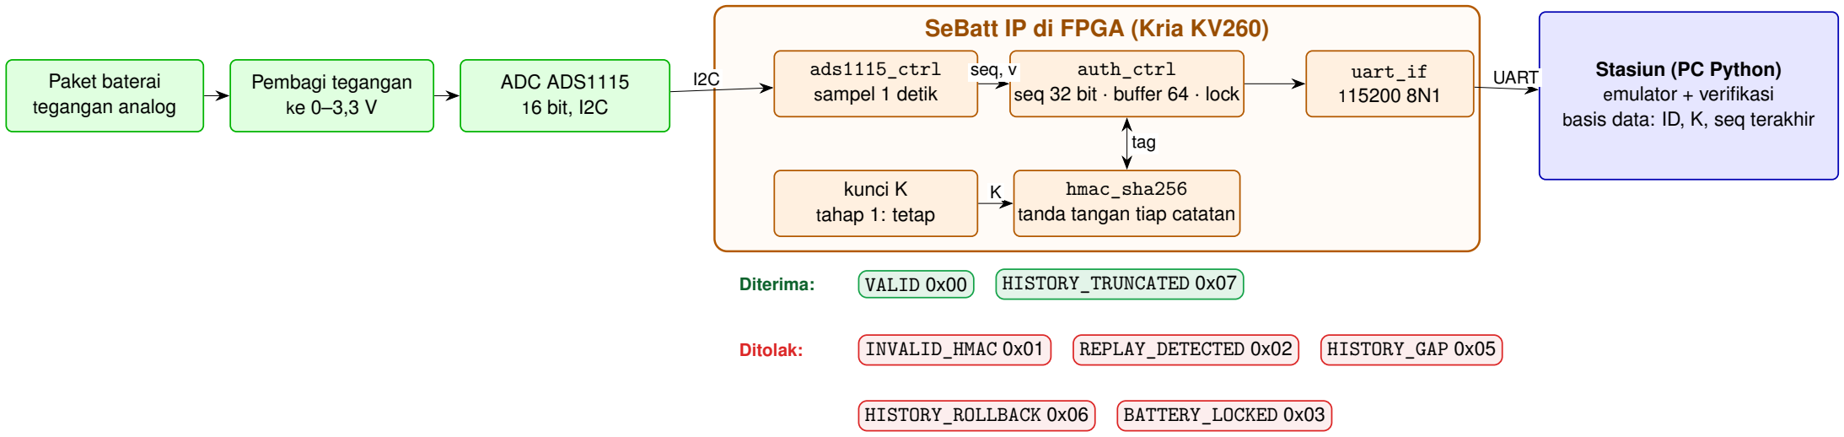
[picture p40: figure]
SeBatt IP di FPGA (Kria KV260); Paket baterai tegangan analog; Pembagi tegangan ke 0–3,3 V; ADC ADS1115 16 bit, I2C; ads1115_ctrl sampel 1 detik; auth_ctrl seq 32 bit · buffer 64 · lock; uart_if 115200 8N1; kunci K tahap 1: tetap; hmac_sha256 tanda tangan tiap catatan; Stasiun (PC Python) emulator + verifikasi basis data: ID, K, seq terakhir; seq, v; UART; tag; Diterima:; VALID 0x00; HISTORY_TRUNCATED 0x07; Ditolak:; INVALID_HMAC 0x01; REPLAY_DETECTED 0x02; HISTORY_GAP 0x05; HISTORY_ROLLBACK 0x06; BATTERY_LOCKED 0x03

Data dari ADC sampai tanda tangan tidak melewati perangkat lunak. Batasan PoC: ADC eksternal, penghitung volatil, kunci simetris di basis data.

## B. Saat baterai ditukar di stasiun

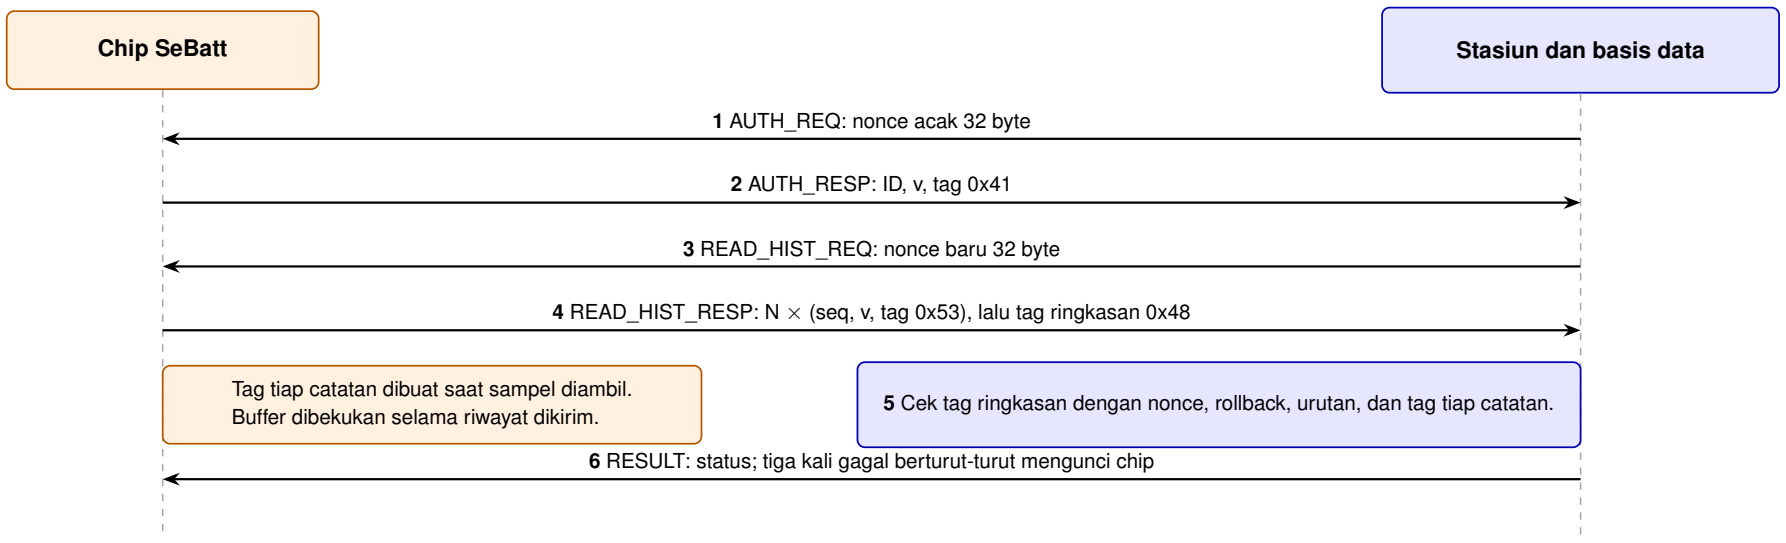
[picture p41: figure]
Chip SeBatt; Stasiun dan basis data; 1 AUTH_REQ: nonce acak 32 byte; 2 AUTH_RESP: ID, v, tag 0x41; 3 READ_HIST_REQ: nonce baru 32 byte

### 4 READ_HIST_RESP: N × (seq, v, tag 0x53), lalu tag ringkasan 0x48

### 6 RESULT: status; tiga kali gagal berturut-turut mengunci chip

Tag tiap catatan dibuat saat sampel diambil.
Buffer dibekukan selama riwayat dikirim. | 5 Cek tag ringkasan dengan nonce, rollback, urutan, dan tag tiap catatan.
