AdakHaddad/mirror_NaSChipHack/docs/gambar/use-case.pdf

# Diagram Use Case — SeBatt

## Keaslian identitas dan integritas riwayat tegangan baterai kendaraan listrik

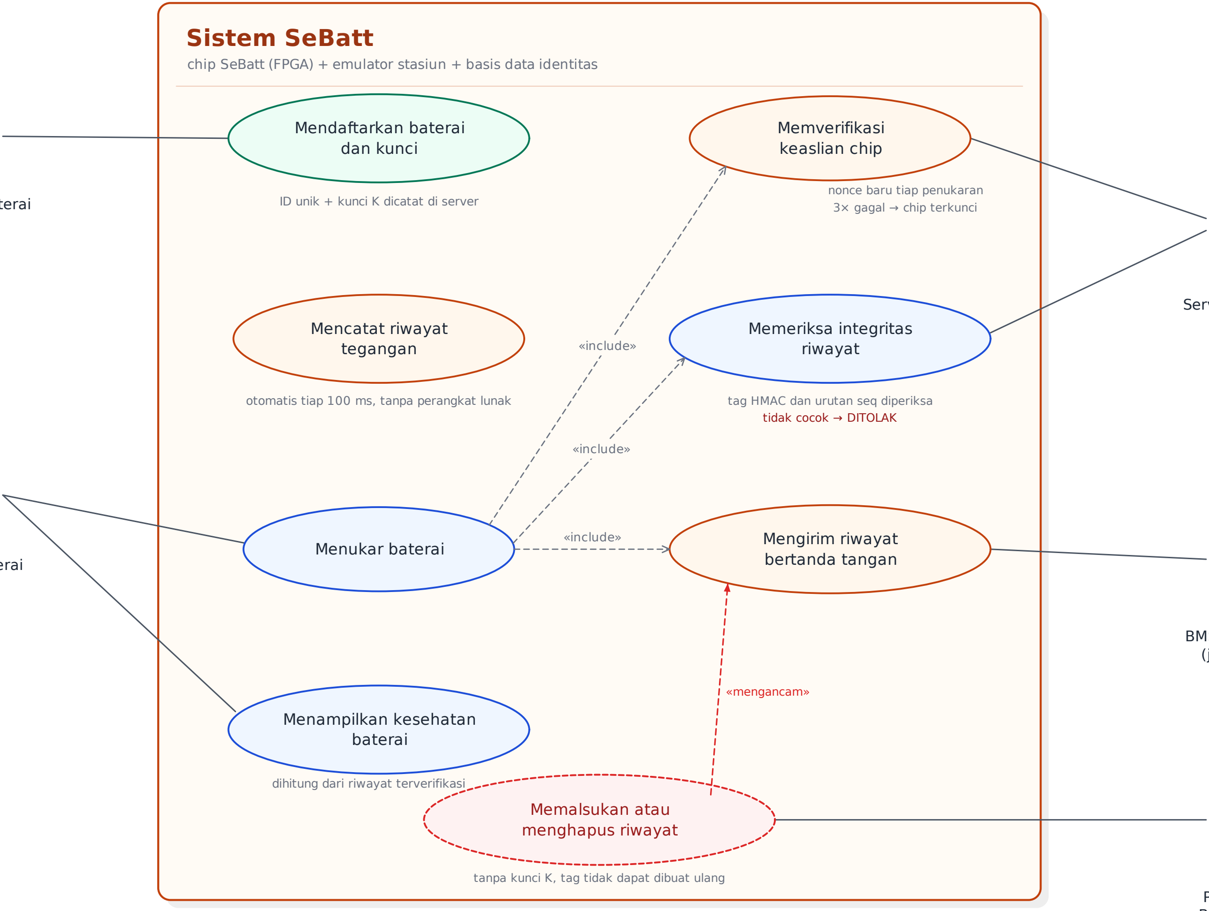
[picture p42: figure]
Sistem SeBatt; Mendaftarkan baterai dan kunci; ID unik + kunci K dicatat di server; Mencatat riwayat tegangan; Menukar baterai; Menampilkan kesehatan baterai; dihitung dari riwayat terverifikasi; Memverifikasi keaslian chip; nonce baru tiap penukaran 3× gagal → chip terkunci; Memeriksa integritas riwayat; tag HMAC dan urutan seq diperiksa tidak cocok → DITOLAK; Mengirim riwayat bertanda tangan; Memalsukan atau menghapus riwayat; «include»; «mengancam»

chip SeBatt (FPGA) + emulator stasiun + basis data identitas

### Produsen baterai

### Pemilik baterai

### Server identitas

### BMS kendaraan (jalur data)

### Penyerang BMS curang

otomatis tiap 100 ms, tanpa perangkat lunak

tanpa kunci K, tag tidak dapat dibuat ulang

Keterangan | fungsi chip SeBatt | stasiun dan server | provisioning | ancaman / misuse
«include» selalu dijalankan | «mengancam» aksi penyerang di jalur data
