AdakHaddad/mirror_NaSChipHack/casing/pratinjau_plat.png

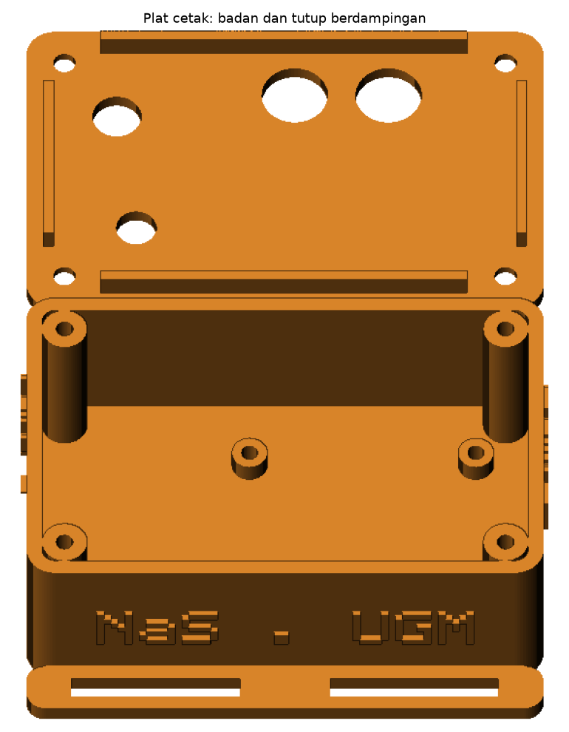
casing/pratinjau_plat.png
