AdakHaddad/mirror_NaSChipHack/docs/gambar/cloud-infra.png

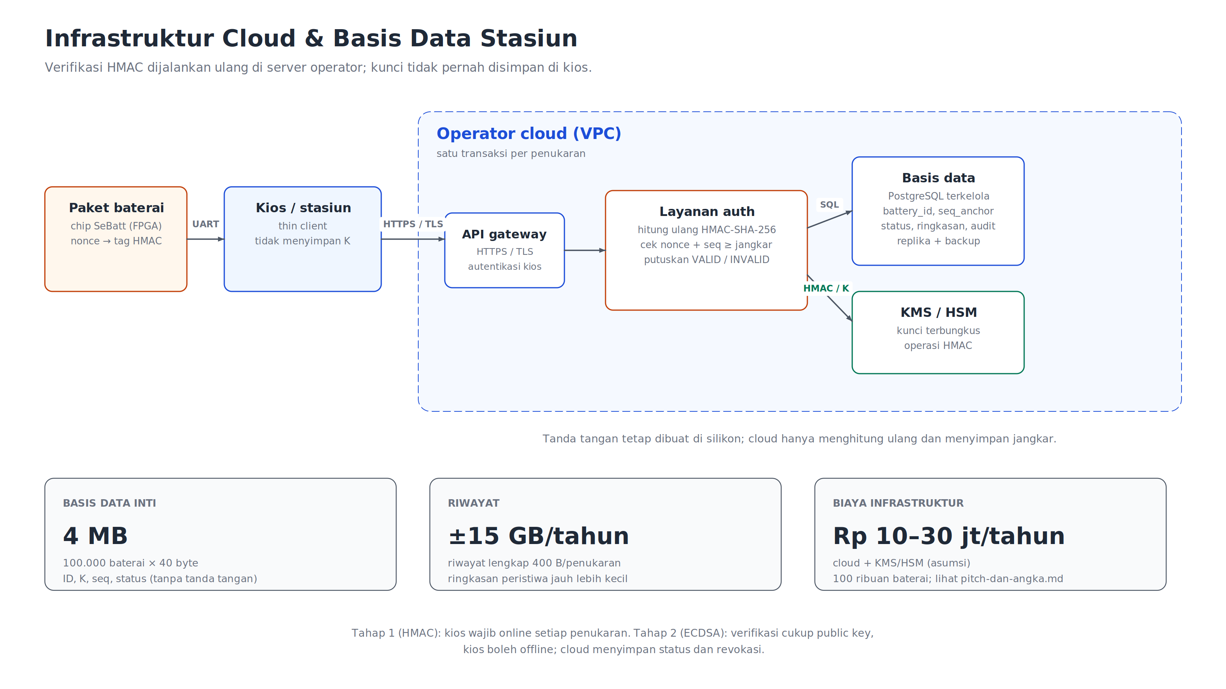
docs/gambar/cloud-infra.png
