AdakHaddad/mirror_NaSChipHack/docs/gambar/use-case.png

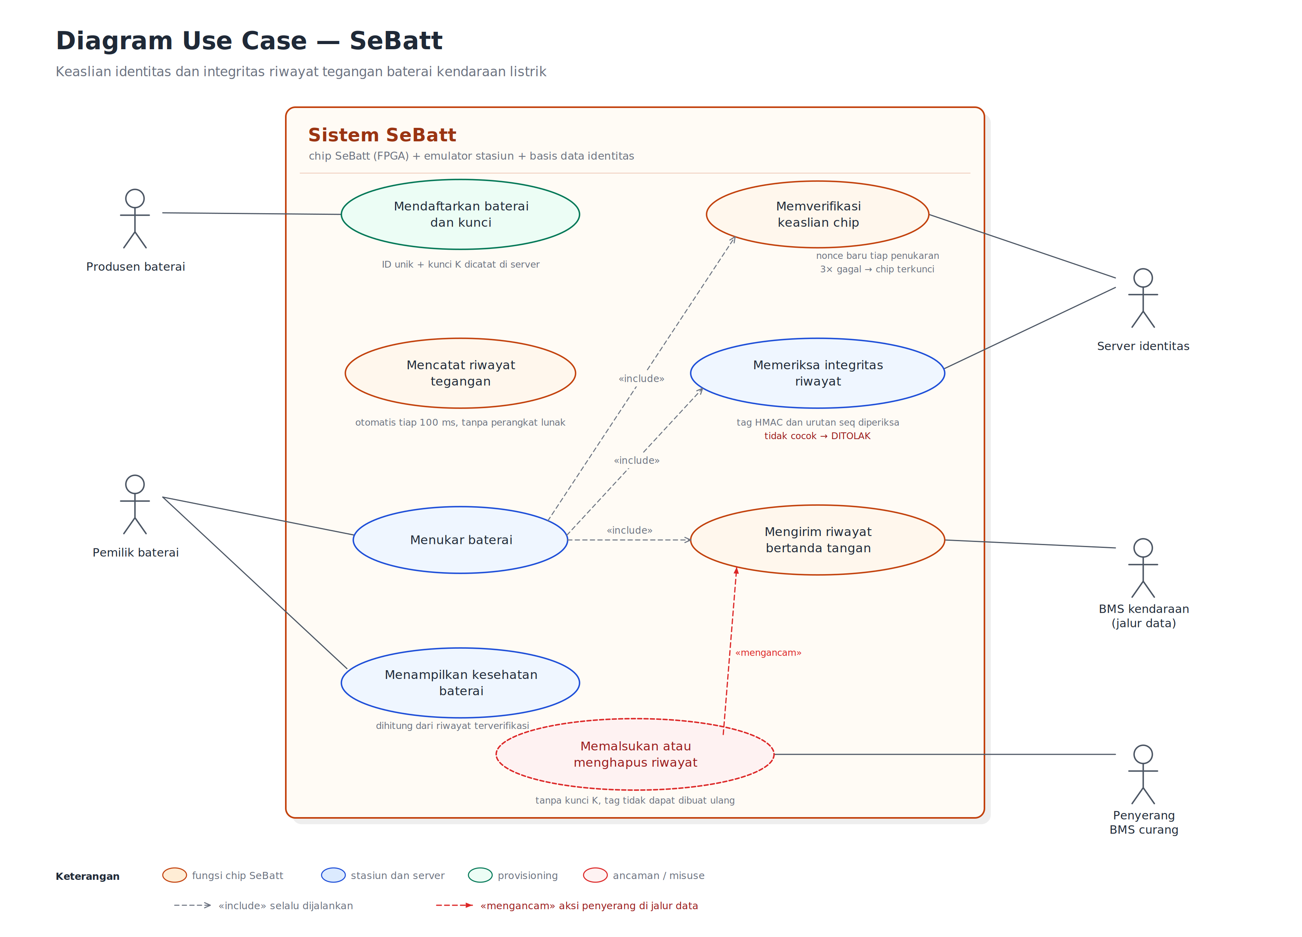
docs/gambar/use-case.png
