AdakHaddad/mirror_NaSChipHack/proposal/figures/header.png

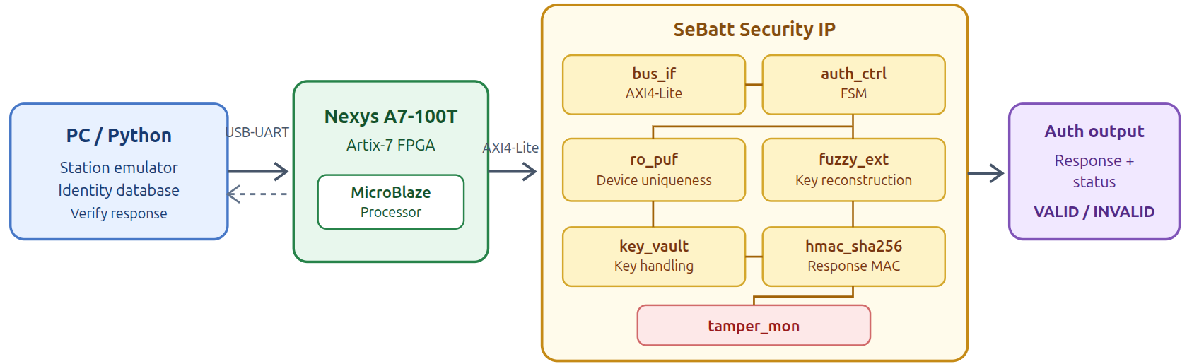
proposal/figures/header.png
