AdakHaddad/mirror_NaSChipHack/casing/sebatt_tutup.stl

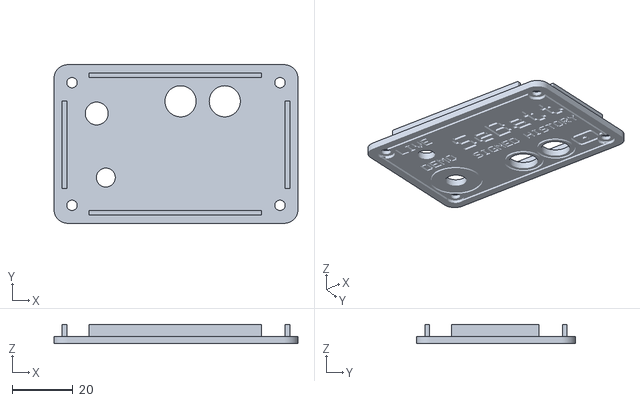
[picture p62: CAD file, 2026-10-20]
casing/sebatt_tutup.stl
80.0 x 52.0 x 6.39
