AdakHaddad/mirror_NaSChipHack/casing/sebatt_plat_cetak.stl

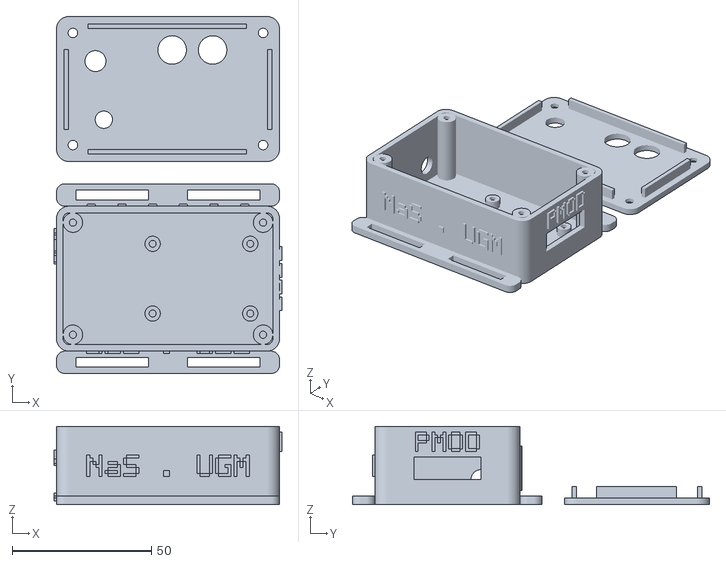
[picture p63: CAD file, 2026-10-20]
casing/sebatt_plat_cetak.stl
81.6 x 128.0 x 28.0
