AdakHaddad/mirror_NaSChipHack/casing/sebatt_badan.stl

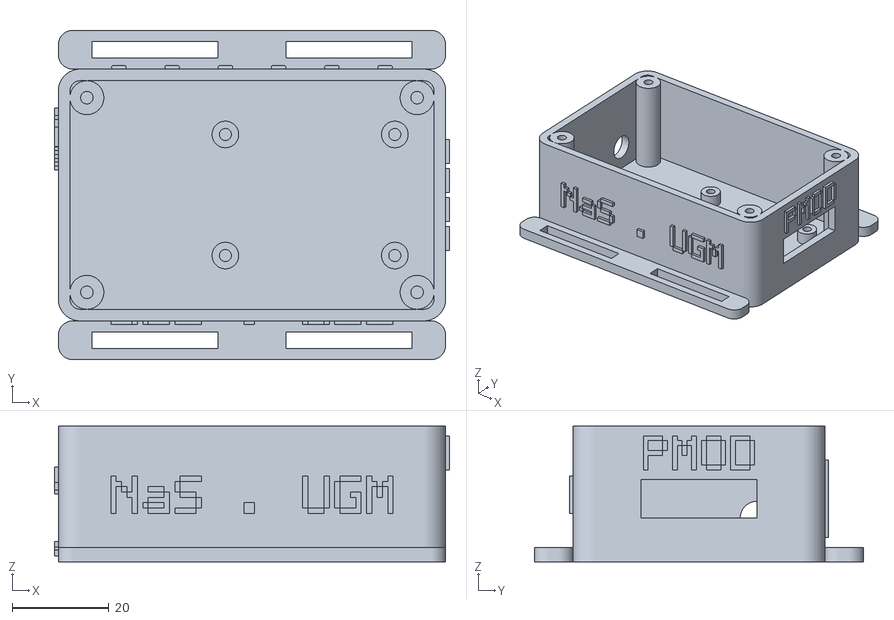
[picture p64: CAD file, 2026-10-20]
casing/sebatt_badan.stl
81.6 x 68.0 x 28.0
