AdakHaddad/mirror_NaSChipHack/fpga/ws/platform_basys3/microblaze_riscv_0/standalone_microblaze_riscv_0/bsp/libsrc/build_configs/gen_bsp/install_manifest.txt

/home/muqtada/Documents/sebatt/fpga/ws/platform_basys3/microblaze_riscv_0/standalone_microblaze_riscv_0/bsp/include/../include/xplatform_info.h
/home/muqtada/Documents/sebatt/fpga/ws/platform_basys3/microblaze_riscv_0/standalone_microblaze_riscv_0/bsp/include/../include/riscv_exceptions_g.h
/home/muqtada/Documents/sebatt/fpga/ws/platform_basys3/microblaze_riscv_0/standalone_microblaze_riscv_0/bsp/include/../include/xil_mem.h
/home/muqtada/Documents/sebatt/fpga/ws/platform_basys3/microblaze_riscv_0/standalone_microblaze_riscv_0/bsp/include/../include/xenv.h
/home/muqtada/Documents/sebatt/fpga/ws/platform_basys3/microblaze_riscv_0/standalone_microblaze_riscv_0/bsp/include/../include/xmem_config.h
/home/muqtada/Documents/sebatt/fpga/ws/platform_basys3/microblaze_riscv_0/standalone_microblaze_riscv_0/bsp/include/../include/xil_sutil.h
/home/muqtada/Documents/sebatt/fpga/ws/platform_basys3/microblaze_riscv_0/standalone_microblaze_riscv_0/bsp/include/../include/xstatus.h
/home/muqtada/Documents/sebatt/fpga/ws/platform_basys3/microblaze_riscv_0/standalone_microblaze_riscv_0/bsp/include/../include/xbasic_types.h
/home/muqtada/Documents/sebatt/fpga/ws/platform_basys3/microblaze_riscv_0/standalone_microblaze_riscv_0/bsp/include/../include/xiltimer.h
/home/muqtada/Documents/sebatt/fpga/ws/platform_basys3/microblaze_riscv_0/standalone_microblaze_riscv_0/bsp/include/../include/xdebug.h
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
/home/muqtada/Documents/sebatt/fpga/ws/platform_basys3/microblaze_riscv_0/standalone_microblaze_riscv_0/bsp/include/../include/xuartlite_l.h
/home/muqtada/Documents/sebatt/fpga/ws/platform_basys3/microblaze_riscv_0/standalone_microblaze_riscv_0/bsp/include/../include/xil_testio.h
