AdakHaddad/mirror_NaSChipHack/docs/gambar/alur-demo.pdf

## A. Susunan meja demo

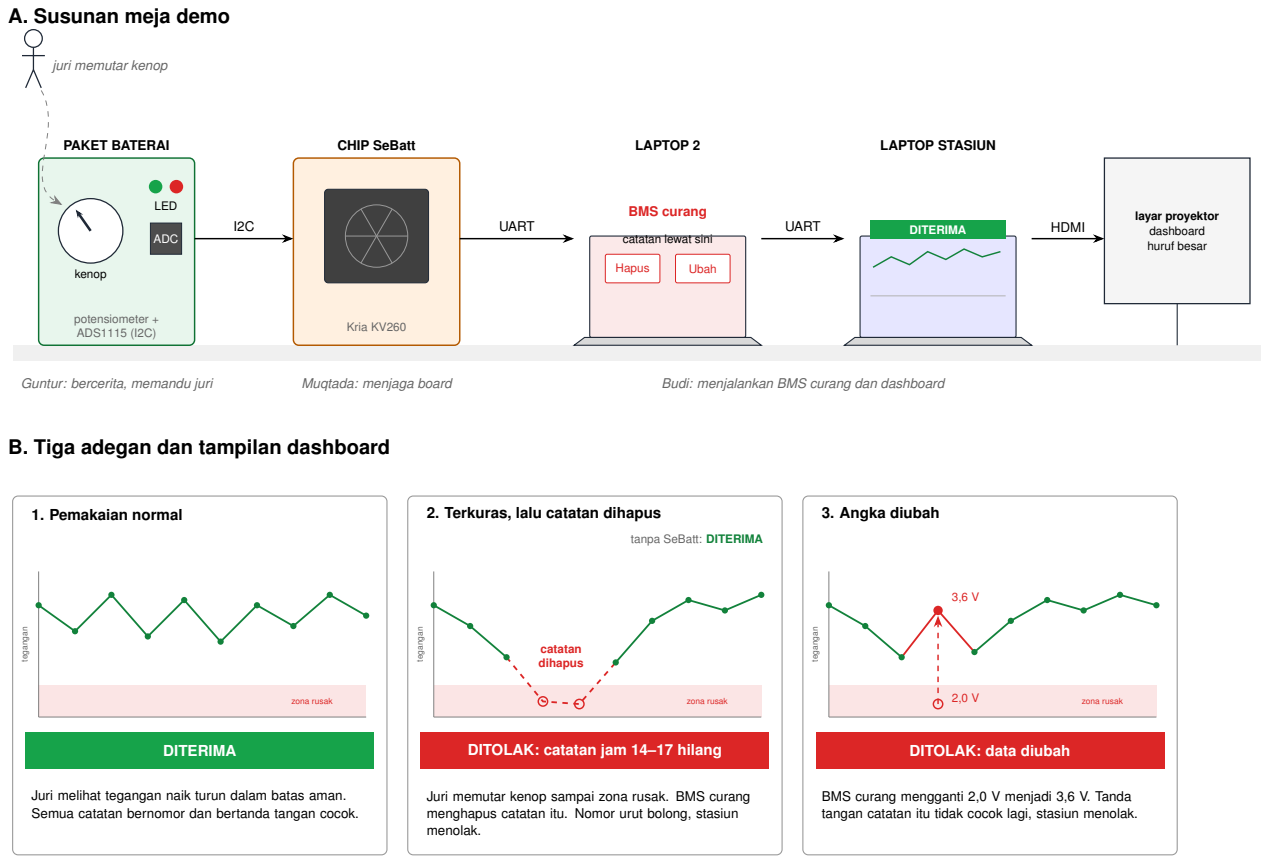
[picture p65: page 1]
PAKET BATERAI; kenop; ADC; LED; potensiometer + ADS1115 (I2C); CHIP SeBatt; Kria KV260; BMS curang; Hapus; Ubah; LAPTOP 2; LAPTOP STASIUN; DITERIMA; layar proyektor dashboard huruf besar; UART; HDMI; Guntur: bercerita, memandu juri; Muqtada: menjaga board; Budi: menjalankan BMS curang dan dashboard; 1. Pemakaian normal; zona rusak; tegangan; catatan dihapus; 3. Angka diubah

juri memutar kenop

catatan lewat sini

B. Tiga adegan dan tampilan dashboard

2. Terkuras, lalu catatan dihapus

tanpa SeBatt: DITERIMA

DITOLAK: catatan jam 14–17 hilang

DITOLAK: data diubah

Juri melihat tegangan naik turun dalam batas aman.
Semua catatan bernomor dan bertanda tangan cocok.

Juri memutar kenop sampai zona rusak. BMS curang
menghapus catatan itu. Nomor urut bolong, stasiun
menolak.

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
