AdakHaddad/mirror_NaSChipHack/docs/gambar/blok-rtl.pdf

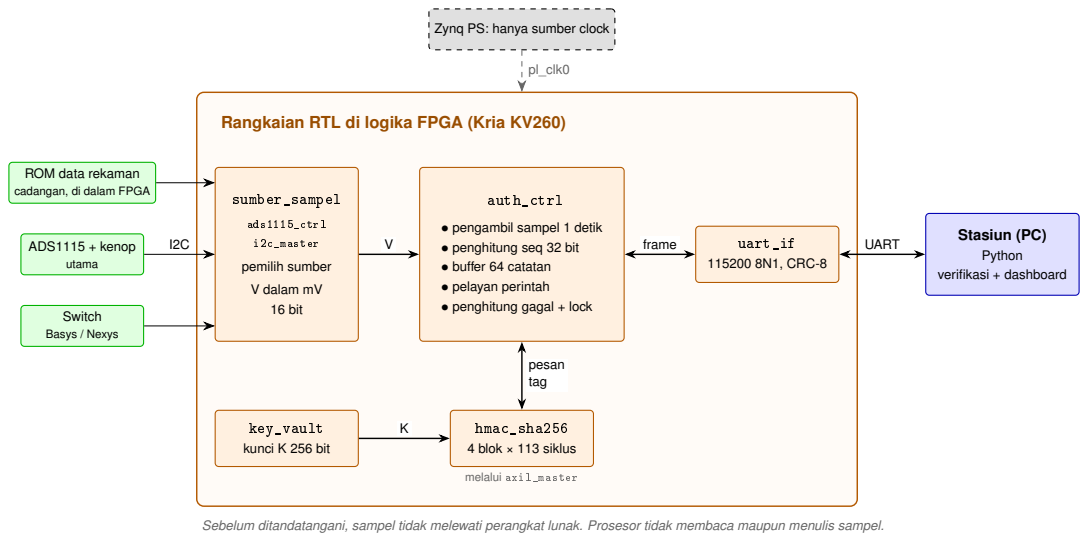
[picture p66: page 1]
ADS1115 + kenop; utama; Switch; Basys / Nexys; sumber_sampel; ads1115_ctrl; i2c_master; pemilih sumber; V dalam mV; 16 bit; auth_ctrl; uart_if; 115200 8N1, CRC-8; hmac_sha256; 4 blok × 113 siklus; melalui axil_master; key_vault; kunci K 256 bit; Stasiun (PC); Python; verifikasi + dashboard; frame; UART; pesan tag; pl_clk0

Zynq PS: hanya sumber clock

Rangkaian RTL di logika FPGA (Kria KV260)

ROM data rekaman
cadangan, di dalam FPGA

• pengambil sampel 1 detik
• penghitung seq 32 bit
• buffer 64 catatan
• pelayan perintah
• penghitung gagal + lock

Sebelum ditandatangani, sampel tidak melewati perangkat lunak. Prosesor tidak membaca maupun menulis sampel.
