AdakHaddad/mirror_NaSChipHack/fpga/ws/_ide/.peers.ini

DefaultTarget=true
ServiceManagerID=59581078-b182-4e4d-baca-de2630901914
TransportName=TCP
AutoSetJtagFrequency=false
PeerTypeId=LINUX_EMULATION
UserName=muqtada
Port=1440
Host=127.0.0.1
OSName=Linux
ID=LinuxEmulation
AgentID=59581078-b182-4e4d-baca-de2630901914
Name=LinuxEmulation

DefaultTarget=true
ServiceManagerID=59581078-b182-4e4d-baca-de2630901914
TransportName=TCP
AutoSetJtagFrequency=false
PeerTypeId=XRT_SERVER
UserName=muqtada
Port=1222
Host=127.0.0.1
OSName=Linux
ID=XRTServer
AgentID=59581078-b182-4e4d-baca-de2630901914
Name=XRTServer

DefaultTarget=true
ServiceManagerID=59581078-b182-4e4d-baca-de2630901914
TransportName=TCP
AutoSetJtagFrequency=true
PeerTypeId=HARDWARE_SERVER
UserName=muqtada
Port=3121
Host=127.0.0.1
OSName=Linux
ID=Local
AgentID=59581078-b182-4e4d-baca-de2630901914
Name=Local

DefaultTarget=true
ServiceManagerID=59581078-b182-4e4d-baca-de2630901914
TransportName=TCP
AutoSetJtagFrequency=false
PeerTypeId=LINUX_TCF_AGENT
UserName=muqtada
Port=1534
Host=192.168.0.1
OSName=Linux
ID=Linux Agent
AgentID=59581078-b182-4e4d-baca-de2630901914
Name=Linux Agent

DefaultTarget=true
ServiceManagerID=59581078-b182-4e4d-baca-de2630901914
TransportName=TCP
AutoSetJtagFrequency=false
PeerTypeId=QEMU_TCF_GDB_CLIENT
UserName=muqtada
Port=1138
Host=127.0.0.1
OSName=Linux
ID=QEMU
AgentID=59581078-b182-4e4d-baca-de2630901914
Name=QEMU
