AdakHaddad/mirror_NaSChipHack/(commit log)

2026-10-14 doc: add signed voltage telemetry for IoT fit
2026-10-14 doc: present fixed key and PUF as two PoC stages
2026-10-14 doc: tie novelty to signing data at the sensor
2026-10-14 doc: tighten narrative flow and update member CVs
2026-10-14 doc: sign voltage history with sequence counter and state PoC limits
2026-10-17 docs(pitch): add business model and Demo Day pitch deck
2026-10-18 doc: add competitor comparison notes for pitch
2026-10-18 doc: add technical flow, demo flow, and meeting notes
2026-10-18 doc: add iphone battery reset example to comparison notes
2026-10-20 code: add casing stl generator script
2026-10-20 img: add battery casing stl and previews
2026-10-20 doc: add casing guide and external adc circuit notes
2026-10-20 doc: add flow b specification and switch adc notes to ads1115
2026-10-20 doc: adopt 1 s sampling and sign-at-sample in specification
2026-10-21 code: fix dump race, crc, parser resync, adc-free source, kv260 heartbeat, station result
2026-10-21 test: add dump race, switch source, and parser resync tests (cocotb 23/23)
2026-10-21 doc: update kv260 pin 4 heartbeat and test counts
2026-10-21 code: add dishonest bms attack commands to interactive station
2026-10-21 img: update protocol flow and regenerate rtl block diagram
2026-10-21 doc: update technical flow with kv260 board results
2026-10-21 test: add kv260 board test report
2026-10-21 doc: document pmod 3 wiring rule and tidy rtl readme
2026-10-21 code: make green/red leds follow the last station verdict
2026-10-21 test: add led verdict regression test (cocotb 24/24)
2026-10-21 doc: update test counts and record led finding
2026-10-21 code: reject i2c transactions on a stuck bus and synchronise sda/scl
2026-10-21 code: add health card, sensor-stall warning, and clearer verdicts to station
2026-10-21 test: add stuck i2c bus and health card tests (cocotb 26/26)
2026-10-21 doc: update test counts and record i2c finding
2026-10-21 docs: add self-check step to board test checklist
2026-10-21 code: add battery health profiles and redesign station dashboard
2026-10-21 test: cover health profiles and battery-scaled dashboard values
2026-10-21 docs: add pitch business numbers with sources and startup positioning
2026-10-21 img: redesign alur-teknis for slides and regenerate demo diagram
    alur-teknis: 16:9 canvas, larger text, exact status codes from spesifikasi.md.
    alur-demo: regenerate from current tex (picks up I2C arrow and caption from 200c754, caption wrapped to stay inside the box).
    pitch_deck: slide 3 now points to the new diagram.
2026-10-21 code: add lipo3s battery profile and profile-driven dashboard chart
2026-10-21 test: cover lipo3s health, chart limits, and forged value
2026-10-21 img: add adc schematic for lipo 3s divider with knob
2026-10-21 doc: describe lipo 3s divider circuit and lipo3s profile
2026-10-21 code: redesign dashboard with step flow, colour-coded panels, and solid verdict
2026-10-22 docs: add English demo-day Q&A prep and refresh pitch test numbers
2026-10-22 code: add cmod s7 counterfeit battery build with patched key copy
2026-10-22 doc: add demo steps and counterfeit battery guide
2026-10-22 doc: add cloud infrastructure slide and diagram to pitch
